leesanghun-droid/A-project/참고자료/6Layer_1.6T(50_90_100) 180306.pptx

A & P.Inc 제품설계팀

모델 :

업 체 : 그린전자
층 수 : 6 Layer
P C B 재 질 : FR-4
요 구 두 께 : 1.6 T
유 전 율 : 4.5(약)
작 성 일 : 2018,03,06
작 성 자 : 홍 성 준

TEST Layer
L2-L1, L2-L3,
L5-L4, L5-L6

Metrial Explain

P.S.R Coating
THIN CORE
PREPREG
COPPER
1080. → 0.06~0.07mm
1081. → 0.11~0.12mm
1082. → 0.17~0.18mm
7628HRC → 0.19~0.20mm
0.5 Oz는 약 0.018mm 1 Oz는 약 0.035mm

THIN CORE

TYPE Single Differential

Ohm 50 90 100

0.5 oz
1 oz
1 oz
1 oz
1 oz
0.5 oz

L1 COMP
1080
L2
L3
2116
L4
L5
1080
L6 SOLD

WIDTH WIDTH SPACE WIDTH SPACE

0.1 0.11 0.2 0.09 0.25
0.145 0.12 0.15 0.1 0.18
0.1 0.11 0.2 0.09 0.25

주의사항 : L3, L4 그라운드 동박 Fill 처리 必
ㄴ 2116 pp 사용에 따른 층간 Void 위험 有

0.5 T

0.5 T

Impedance Control : 50, 90, 100 (Ohm± 10%)
예 상 Thickness : 1.54 T

단위: mm
