leesanghun-droid/A-project/참고자료/FN210-RPI-W/FN210-RPI-W/FN210-RPI-W_부품배치도.pptx

주요내용

- 부품 변경 사항 – 스위치(SW1-4), EXT_MIC(4개)
  - 변경 부품
    - 전원스위치(SW1) / USER 스위치(SW2-4) – TOP에 배치 가능한 부품으로 변경하였습니다. – 회로도 수정 되었음.
(영성정공 ITS-1102T (https://www.devicemart.co.kr/goods/view?no=4305) + 스위치 노브(캡) NW3-A44 (https://www.devicemart.co.kr/goods/view?no=1322134))
    - EXT_MIC – Right Angle 제품으로 변경(Molex 5268-04 (http://www.icbanq.com/P000139721)) – PCB Footprint HDR4를 변경해주시면 될 것 같습니다.
(회로도에서 수정 없음)
- 마이크 간격 12cm로 유지 부탁드립니다.
- 지지대 홀 위치는 케이스에 따라 변경 가능합니다.
- 인터페이스(커넥터) 배치 주의사항.
  - 케이스 각 옆면 중앙에는 외부 마이크 배치될 수 있습니다.
  - 인터페이스 간 간격이 여유롭게 배치되었으면 합니다.
  - 케이스(Mic hole)와 PCB Top면의 간격에 따른 차이를 테스트할 예정입니다.

## Slide 2

케이스 배치 예상도

영역 외부 마이크를 위한 공간예정 - hole이 아님.

영역 PCB 보드 예상

마이크 hole – 보드 마이크와 밀착
스위치 4개 hole
(전원(SW1), USER 3개(SW2-4))
위치 미정
– 버튼 별 표시 중요

SW1

SW

SW

SW

Mic 간격
12cm

케이스 길이 180mm

U10
(Ethernet)

U7
(USB)

J8
(HDMI)

J1
(USB)

CON1
(SD)

J6 (AUDIO)

케이스 길이
155mm

TOP

BOTTOM

## Slide 3

TOP

SW1

SW2

MIC1

MIC2

MIC4

MIC3

Mic 간격
12cm

Mic 간격
12cm

LED1

LED2

SW3

W1
(WIFI)

LED3

LED4

SW4

- 지지대홀( ) 위치 미정
– 케이스에 맞추어 변경 가능
- LED/스위치 위치 미지정

## Slide 4

BOTTOM

J12 (SODIMM)

U10
(Ethernet)

U7
(USB)

J7

J11
(DEBUG)

J1
(USB)

EXT_MIC1

EXT_MIC2

EXT_MIC3

EXT_MIC4

CON1
(SD)

J6 (AUDIO)

J8
(HDMI)

- J7/J11 위치 미정
- EXT_MIC1-4 위치 미지정

J10 (CAM)

J9 (DISP)
