leesanghun-droid/A-project/참고자료/기본 4층 1.6T 50_90_100 (0.2PP_1.1T).pdf

4 Layer | 1.6 T
Target Zo | Ref.L | W | D | Target Zo | Ref.L | W | S | D | Target Zo | Ref.L | W | S | D
S/R | 0.012 | 3.50
1 | Top | 1/2oz+Plating | 0.040 | 2 | 0.355 | 2 | 0.170 | 0.100 | 2 | 0.150 | 0.120
Prepreg | 7628HRC | 0.200 | 4.18
2 | IN1 | 1oz | 0.032
Core | 1.1 | 1.040 | 4.30
3 | IN2 | 1oz | 0.032
Prepreg | 7628HRC | 0.200 | 4.18
4 | Bot | 1/2oz+Plating | 0.040 | 3 | 0.355 | 3 | 0.170 | 0.100 | 3 | 0.150 | 0.120
S/R | 0.012 | 3.50
| | | 1.608
DATE: | Impedance Controled
Stack_up | Singal Impedance | Differential Impedance
W: Line width | S: Line space | D: GND space | (unit: mm)

## Customer:

Layer: | Board Thickness:

90ohm (±10%)

Total Thickness

Layer | Type | Structure | Thickness | Er
50ohm (±10%) | 100ohm (±10%)
