leesanghun-droid/A-project/참고자료/FN210-RPI-W/FN210-RPI-W/FN210-RPI-W_차기버전_문의.pptx

케이스 관련 문의사항 – 차기 버전 확인 사항

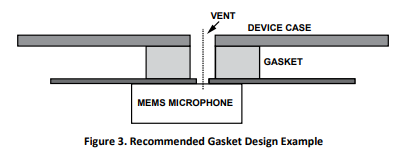
[picture p2: figure]

1. 마이크와 케이스를 밀착 시켜야 합니다. – 관련 문서 pdf 참조
또는, 옆의 그림 처럼 처리되어야 할 것 같습니다.
스위치 타공 부분을 살짝 크게 하여 최대한 밀착하였으면 합니다.
2. 케이스 가공 여부 확인 부탁 드립니다.
- 옆면 홈 부분 타공 가능한지 여부 – 실제 적용은 미정
- TOP면 6개 제거 가능 여부 – 보드 밀착 관련
- MIC 관련 – 케이스가 두꺼워 아래 빨간 박스부분에도 Gasket처리를 원합니다. - 이 경우 홀 최소 크기 문의

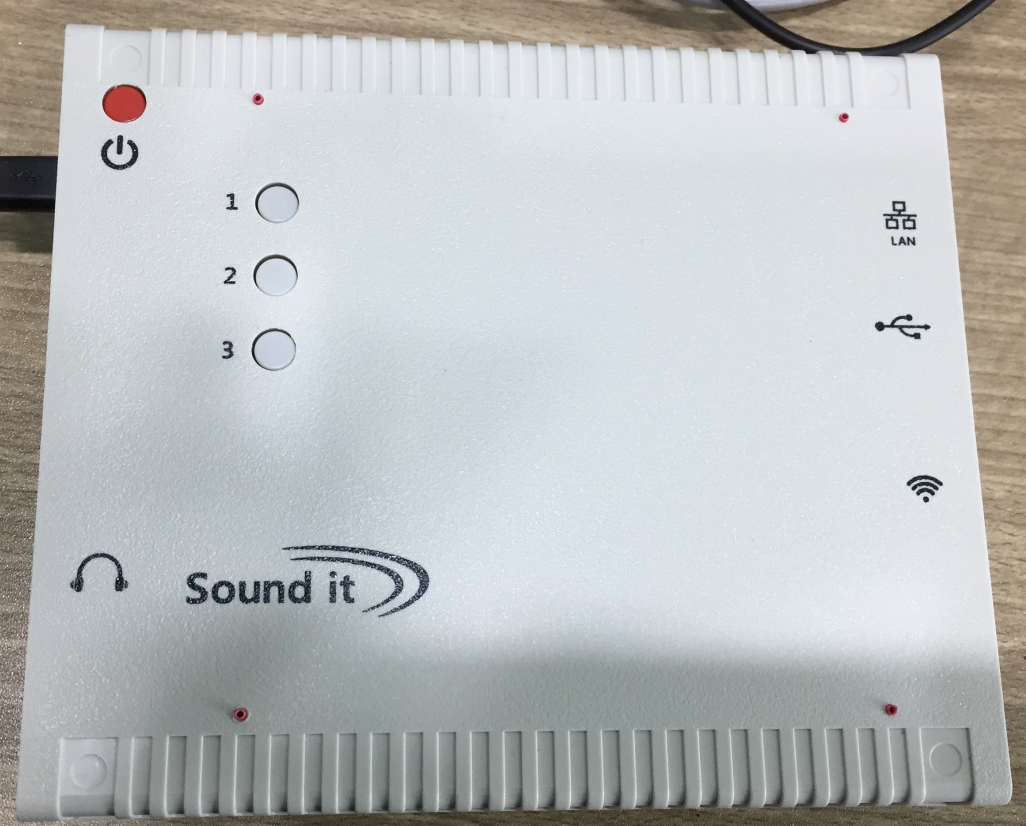
[picture p3: figure]
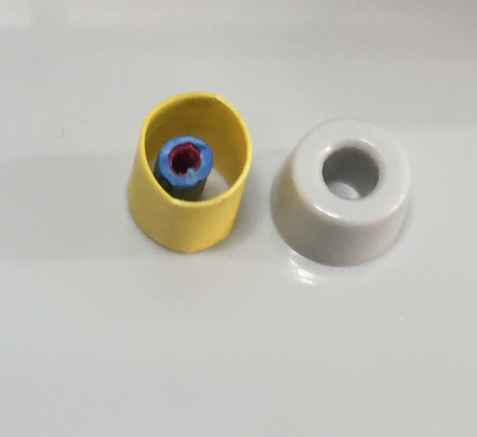
[picture p4: figure]

현재 Gasket 테스트

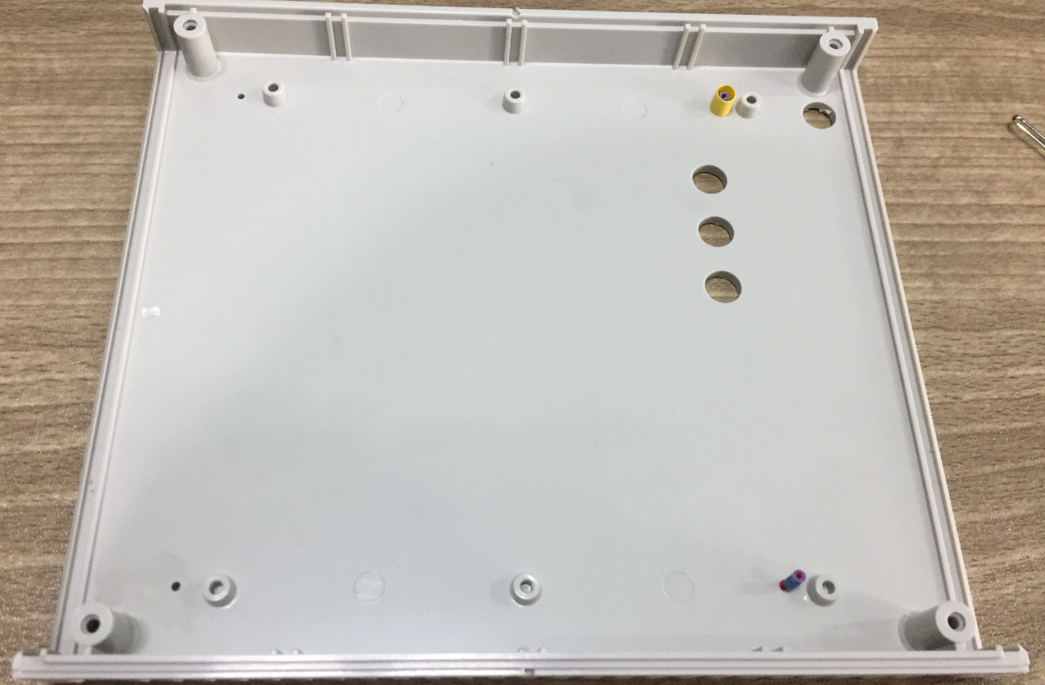
[picture p5: figure]
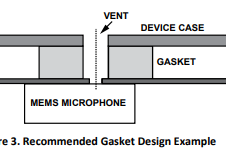
[picture p6: figure]

## Slide 2

차기 버전 변경 사항 - 예정

1. LED 순서 변경
2. J12(DDR2 SODIMM), W1(WiFi Module) Bottom면 배치
3. 외부 마이크 부분 변경 가능
4. 케이스 실크 변경
