leesanghun-droid/A-project/참고자료/FN210-RPI-W/FN210-RPI-W/배치 수정 부분.pptx

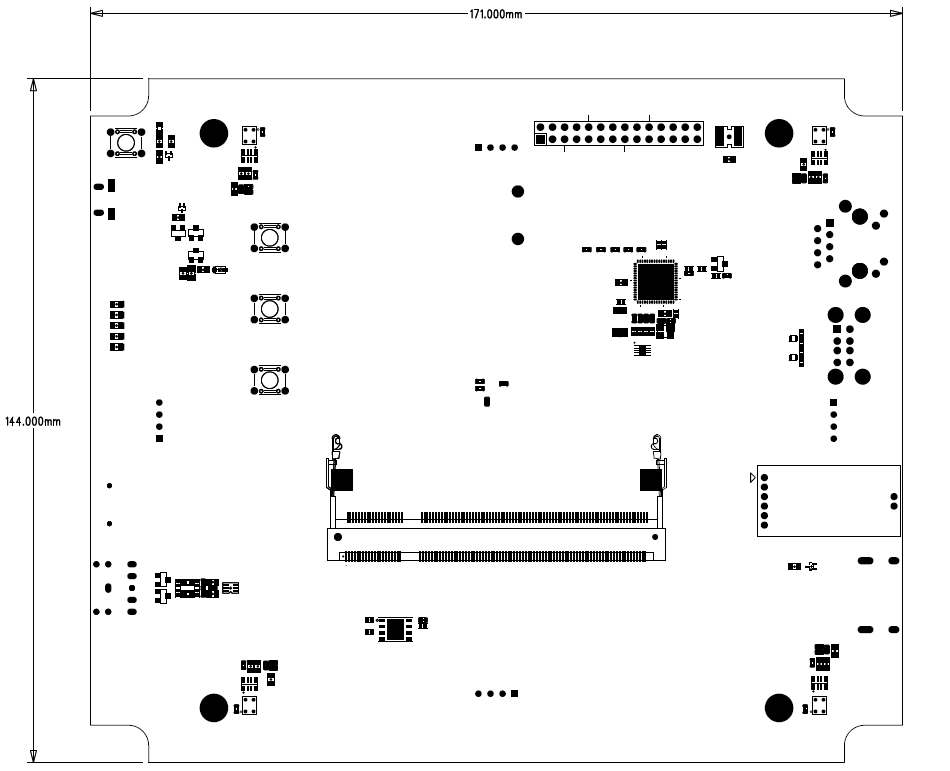
[picture p7: figure]

## Slide 2

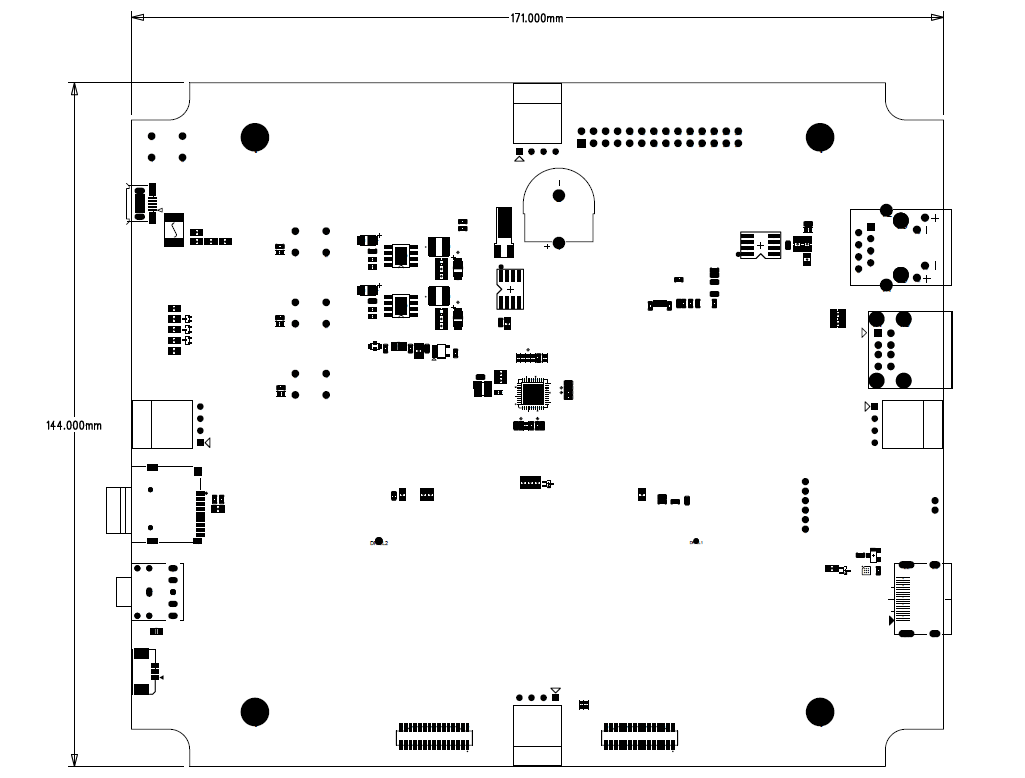
[picture p8: figure]
