leesanghun-droid/A-project/참고자료/FN210-RPI-W/FN210-RPI-W/pin_header_right_angle.pdf

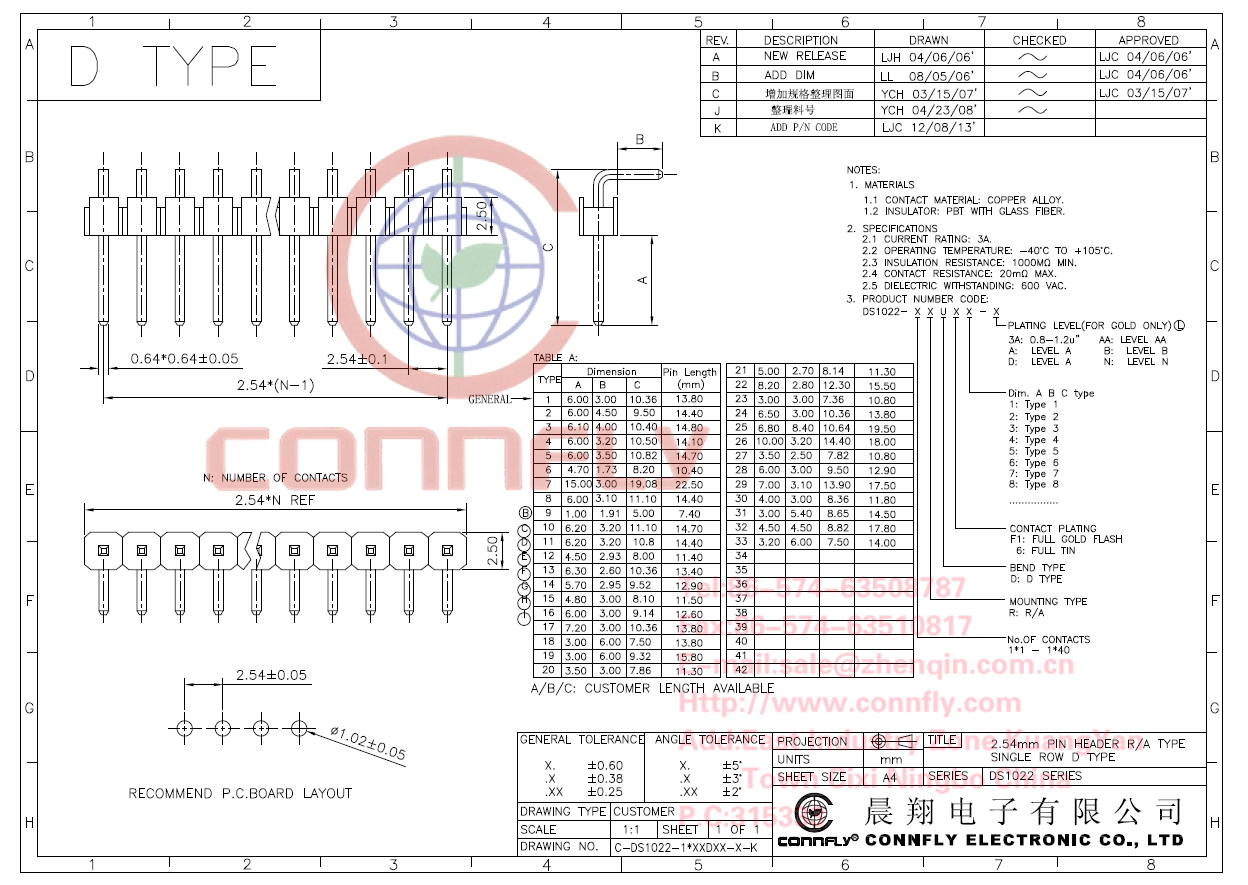
[picture p9: page 1]
