leesanghun-droid/A-project/참고자료/FN210-RPI-W/FN210-RPI-W/DataSheet/switch_Tact6_343.jpg

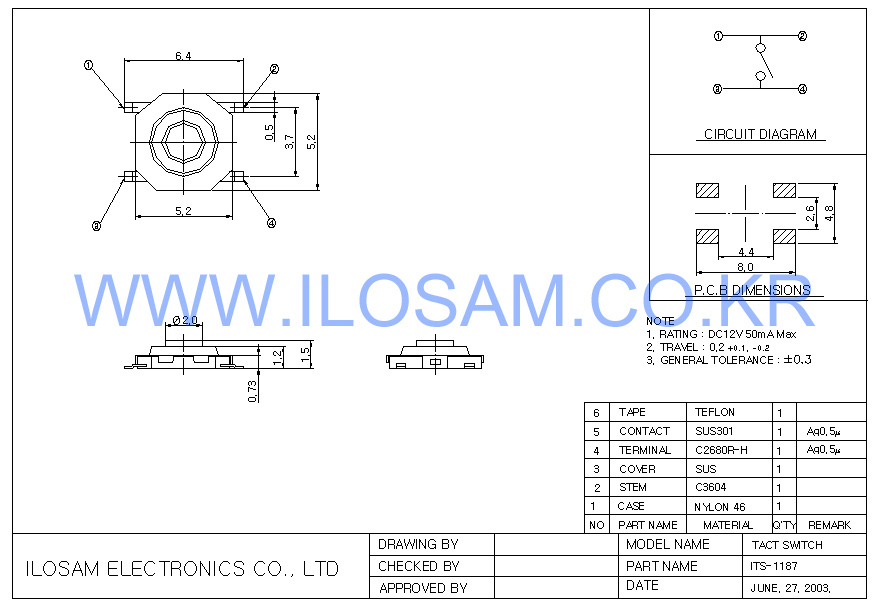
참고자료/FN210-RPI-W/FN210-RPI-W/DataSheet/switch_Tact6_343.jpg
