leesanghun-droid/A-project/참고자료/FN210-RPI-W/FN210-RPI-W/FN210-RPI-W_SOUNDIT_REV_A(190304)SCH-1AA.png

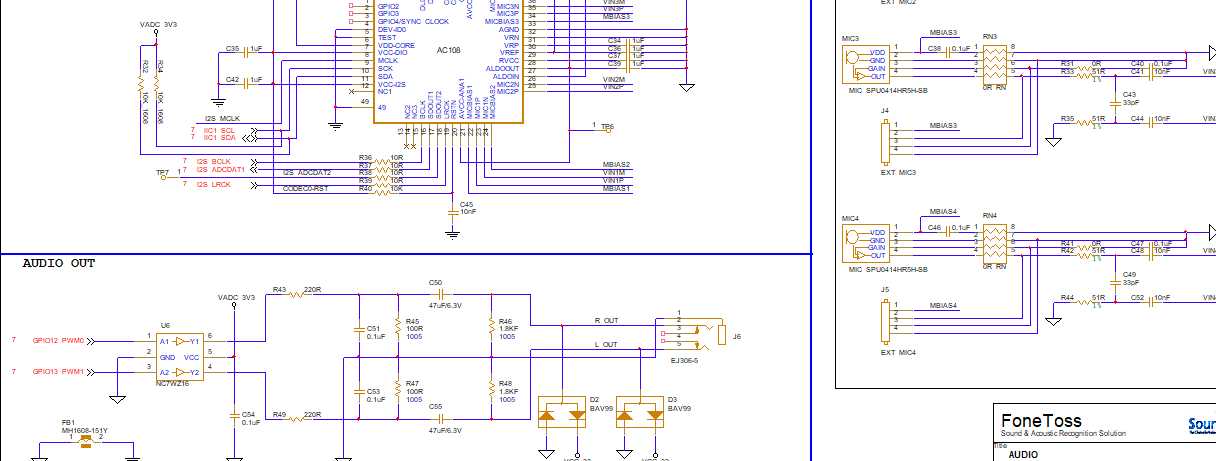
참고자료/FN210-RPI-W/FN210-RPI-W/FN210-RPI-W_SOUNDIT_REV_A(190304)SCH-1AA.png
