leesanghun-droid/A-project/참고자료/캡처1.PNG

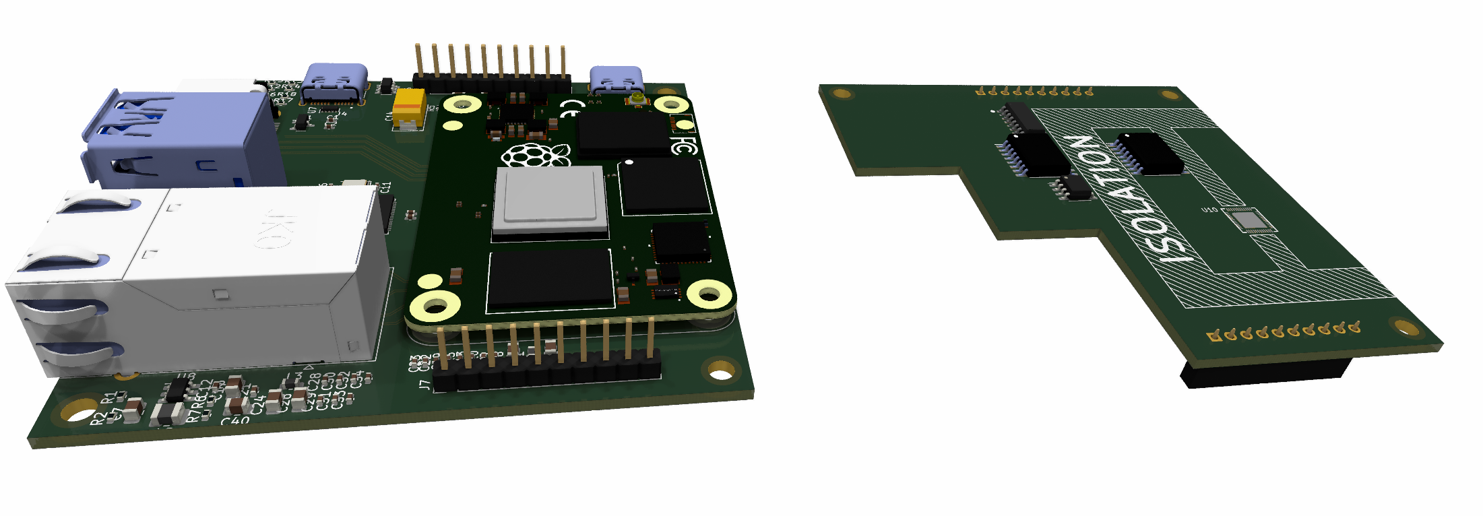
참고자료/캡처1.PNG
