leesanghun-droid/A-project/참고자료/AUDIO_BOM_2023.02.13.xlsx

[BOM] A 보드
Stock | Item | Quantity | Reference | Part | Descreption | 구매링크 | Package | PCB_Footprint | Vendor
 |  | 1 |  | AC108 | AUDIO CODEC | 알리바바
 |  | 1 |  | VL805 | USB 3.0 HUB | 알리익스프레스
 |  | 1 |  | DF40C-100DS-0.4V | CM4 CONNECTER | 알리익스프레스
 |  | 1 |  | RT9742SNGV | HDMI POWER SWITCH | 디바이스마트
 |  | 1 |  | DMG1012T | VL805 POWER MOSFET | 디바이스마트
 |  | 1 |  | AP22653W6 | CURRENT LIMIT SWITCH | 디바이스마트
 |  | 1 |  | X1G005961000212 | 25MHz ( VL805 ) | 디바이스마트 | 3225
 |  | 1 |  | SS-52000-003 | USB 3.0 STACKED | 디바이스마트 |  |  | Stewart Connector
 |  | 4 |  | TPD4EUSB30DQAR | USB 2.0 ESD | 디바이스마트 |  |  | TI
 |  | 2 |  | BLM18AG221SN1 | FERRITE BEAD 220 OHM | 디바이스마트 | 0603 |  | Murata Electronics
 |  | 35 |  | CL05B104JO5NNNC | 100nF | 디바이스마트 | C_0402_1005Metric |  | 삼성전기
 |  |  |  |  | 1uF |  | C_0402_1005Metric
 |  | 8 |  | CL21B106KOQNNNE | 10uF | 디바이스마트 |  |  | 삼성전기
 |  | 1 |  | JK0-0177NL | RJ45 / 1000Mbps | 알리익스프레스
 |  | 2 |  | 105450-0101 | USB C TYPE | 디바이스마트
 |  | 1 |  | AP3445LW6-7 | SWITCH REG | 디바이스마트
 |  | 1 |  | SI8663BB-B-IS1 | ISO INTERFACE IC | 디바이스마트
 |  | 2 |  | R05CTE05S-R | ISO POWER IC | 디바이스마트
 |  | 1 |  | ISO1540QDRQ1 | ISO I2C | 디바이스마트
 |  | 2 |  | TCR3RM33A,LF(SE | high precision LDO | 디바이스마트
 |  | 4 |  | Grove Female Header | Grove Female Header | 디바이스마트
 |  | 1 |  | ASEMB-24.000MHZ-LC-T | AC108 CLOCK | 디바이스마트
 |  | 1 |  | 685119134923 ( HDMI ) | HDMI CONNECTER | 디바이스마트
 |  | 2 |  | T495B107M010ATE500 | CAP TANT 100UF 10V 20% 2528 | 디바이스마트
260 |  |  |  | 0.1uF 16V 0402 |  |  | C_0402_1005Metric
 |  | ~~1~~ | ~~J6~~ | ~~MOLEX_503398-1892~~ | ~~SD-CARD~~ | ~~디바이스마트~~
 |  | ~~1~~ | ~~J2~~ | ~~HD02-19-M-MSMT-TR~~ | ~~HDMI CONNECTER~~ | ~~디바이스마트~~
 |  | ~~1~~ | ~~U6~~ | ~~AP3428KTTR-G1~~ | ~~3.3V to 1.05V~~ | ~~마우저~~
 |  | ~~1~~ | ~~U7~~ | ~~AP2127K-ADJTRG1~~ | ~~3.3V to 1.05V~~ | ~~디바이스마트~~
 |  | ~~1~~ | ~~J4~~ | ~~SS-52100-003~~ | ~~USB 2.0 STACKED~~ | ~~디바이스마트~~ |  |  | Stewart Connector
 |  | ~~2~~ | ~~U9~~ | ~~74LVC1G07GW,125~~ | ~~BUF NON-INVERT 5.5V~~ | ~~디바이스마트~~ | 5TSSOP |  | Nexperia USA Inc.
