leesanghun-droid/A-project/참고자료/FN210-RPI-W/FN210-RPI-W/FN210-RPI-W_SOUNDIT_REV_A_BOM_20190304.xlsx

[BOM] FN210-RPI-W Rev.A
Item | Quantity | Reference | Part | Package | PCB_Footprint | Vendor | Descreption
1 | 1 | BT1 | CR1220 | CR1220 | BATTERY(HOLDER_CR1220)DIP | Keystone Electronics | Coin Cell Battery Holders
2 | 1 | CON1 | SCHA1B0100 | SCHA1B0100 (http://www.icbanq.com/P004961798) | CARD-ATOM | Chipsen | Micro SD Socket
3 | 4 | CT1,CT2,CT3,CT4 | 10uF_TANA | TAN_A | TAN_A | AVX | 10V/3216/20%
4 | 3 | C1,C4,C6 | 0.1uF_1608 | C1608 | C1608
5 | 1 | C2 | 22uF | c2012 | C2012
6 | 16 | C3,C5,C15,C16,C22,C23,C25,C29,C30,C33,C34,C35,C36,C37,C39,C42 | 1uF | C1005 | C1005
7 | 1 | C7 | 1nF | C4532 | C4532
8 | 4 | C8,C9,C56,C57 | 47uF | c2012 | C2012
9 | 40 | C10,C11,C12,C13,C17,C18,C24,C26,C38,C40,C46,C47,C51,C53,C54,C60,C61,C62,C63,C65,C66,C67,C68,C69,C70,C71,C72,C73,C74,C75,C76,C78,C79,C84,C87,C88,C89,C90,C94,C95 | 0.1uF | C1005 | C1005
10 | 1 | C14 | 10uF_2012 | c2012 | C2012
11 | 10 | C19,C21,C28,C32,C41,C44,C45,C48,C52,C98 | 10nF | C1005 | C1005
12 | 6 | C20,C31,C43,C49,C85,C86 | 33pF | C1005 | C1005
13 | 2 | C27,C97 | 10uF | C1005 | C1005
14 | 2 | C50,C55 | 47uF/6.3V | C1608 | C1608
15 | 1 | C58 | 1uF/6.3V | C1005 | C1005
16 | 5 | C59,C64,C77,C96,C99 | 4.7uF | C1005 | C1005
17 | 4 | C80,C81,C82,C83 | 100pF | C1005 | C1005
18 | 3 | C91,C92,C93 | 0.22uF | C1005 | C1005
19 | 1 | DN1 | ESD1014MUTAG | UDFN-10 | UDFN10 | ON Semiconductor | TVS Diodes - Transient Voltage Suppressors LOW CAP TVS ARRAY
20 | 1 | D1 | 1SS315TPH3F | USC-2 | DIODE_USC | TOSHIBA | Schottky Diodes & Rectifiers PIN DIODE
21 | 2 | D2,D3 | BAV99 | SOT-23-3 | SOT23 | ON Semiconductor | Diodes - General Purpose, Power, Switching 70V 215mA Dual
22 | 4 | D4,D5,D6,D7 | LXES15AAA1-133 | ESD1005 | ESD_1005 | Murata Electronics | ESD Suppressors
23 | 1 | FB1 | MH1608-151Y | L1608 | L1608 | Bourns | Ferrite Beads
24 | 2 | FB2,FB3 | LC 90 150mA 0504 | MCF12102H900 | MCF12102H900 | Taiyo Yuden | Common Mode Chokes / Filters 1210 0.15A 90ohms Com Mode Choke Coil
25 | 2 | FB4,FB5 | BLM18PG121 | L1608 | L1608 | Murata | Ferrite Beads 0603
26 | 1 | F1 | MF-MSMF200 | 1812(4532 metric) | FUSE_4532 | Bourns | Resettable Fuses - PPTC
27 | 1 | J1 | USB5F | HI05-AG0272 | USB-MICRO_HI05-AG0272 | 협진 | MICRO USB B
28 | 1 | J2 | EXT_MIC1 | 5268-04 | HDR4 | Molex
29 | 1 | J3 | EXT_MIC2 | 5268-04 | HDR4 | Molex
30 | 1 | J4 | EXT_MIC3 | 5268-04 | HDR4 | Molex
31 | 1 | J5 | EXT_MIC4 | 5268-04 | HDR4 | Molex
32 | 1 | J6 | EJ306-5 | PJ-307 (http://www.icbanq.com/P005658810) | PHONEJACK-EJ306-5 | GEC | 3.5Pie Phone Jack
33 | 1 | J7 | GPIO |  | HDR14X2
34 | 1 | J8 | 47151-1051 | 47151-1051 | HDMI_47151-001 | Molex | HDMI, Displayport & DVI Connectors
35 | 2 | J9,J10 | 1-1734248-5 | 1-1734248-5 | 117342485 | TE Connectivity AMP Connectors] | CONN FPC VERT 15POS 1.00MM SM
36 | 1 | J11 | DEBUG | 53398-0371 | MOLEX53398-03 | Molex | Headers VERTICAL HDR SMT 3P
37 | 1 | J12 | DDR2 SODIMM | 1473149-4 | TE_14731494 | TE Connectivity AMP Connectors | DIMM Connectors .6MM 200D R/SM 1.8V DIMMSO DDR
38 | 1 | LED1 | WHITE | D1608 | LED1608
39 | 1 | LED2 | RED | D1608 | LED1608
40 | 1 | LED3 | GREEN | D1608 | LED1608
41 | 1 | LED4 | BLUE | D1608 | LED1608
42 | 1 | LED5 | YELLOW | D1608 | LED1608
43 | 2 | L1,L2 | 4.7u | SRN4018-4R7M | SRN4018 | Bourns | Fixed Inductors
44 | 1 | L3 | FLT_HIFREQ_.47UF | YFF21PC | YFF21PC | TDK | Feed Through Capacitors
45 | 2 | L4,L5 | BLM21PG221SN1D | L2012 | L2012 | Murata | Ferrite Beads 0805
46 | 4 | MH1,MH2,MH3,MH4 | MHOLE |  | HOLE3.5-NTH
47 | 4 | MIC1,MIC2,MIC3,MIC4 | MIC_SPU0414HR5H-SB | SPU0414HR5H-SB | MIC-SPU0414HR5H-SB | Knowles | MEMS Microphones
48 | 1 | Q1 | IRLML6401 | SOT-23-3 | SOT23 | Infineon Technologies | MOSFET MOSFT P-Ch -4.3A 50mOhm 10nC Log Lvl
49 | 5 | Q2,Q5,Q8,Q9,Q10 | DTC124EE | SOT-416-3 | SOT-416 | ROHM Semiconductor | Digital Transistors DIGITAL NPN 50V 100MA EMD3
50 | 2 | Q3,Q4 | DMG3420U-7 | SOT-23-3 | SOT-23-3 | Diodes Incorporated | MOSFET Small Signal MOSFET,N-CHANNEL
51 | 3 | Q6,Q7,Q11 | DMG1012T | SOT-523-3 | SOT523 | Diodes Incorporated | MOSFET BVDSS
52 | 4 | RN1,RN2,RN3,RN4 | 0R_RN | RN3216 | RNET3216 | Bourns | Resistor Networks & Arrays 000ohm 5% Concave 4resistors
53 | 10 | R2,R3,R20,R24,R27,R31,R41,R77 | 0R | R1608 | R1608
54 | 3 | R4,R5,R6 | 10KJ | R1608 | R1608
55 | 3 | R7,R8,R72,R73,R80 | 1KJ | R1608 | R1608
56 | 1 | R9 | 10R_1608 | R1608 | R1608
57 | 2 | R10,R85 | 100KJ_1608 | R1608 | R1608
58 | 4 | R11,R12,R15,R16 | 100KJ | R1005 | R1005
59 | 1 | R13 | 47KF | R1608 | R1608
60 | 2 | R14,R17 | 15KF | R1608 | R1608
61 | 1 | R18 | 12KF | R1608 | R1608
62 | 1 | R19 | 1M1 | R1608 | R1608
63 | 1 | R21 | 47K | R1005 | R1005
64 | 1 | R22 | 2.2K | R1005 | R1005
65 | 6 | R23,R36,R37,R38,R39,R62 | 10R | R1005 | R1005
66 | 8 | R25,R26,R28,R30,R33,R35,R42,R44 | 51R | R1608 | R1608
67 | 9 | R29,R40,R52,R63,R64,R65,R67,R68,R69 | 10K | R1005 | R1005
68 | 2 | R32,R34 | 10K_1608 | R1608 | R1608
69 | 6 | R43,R49,R50,R74 | 220R | R1608 | R1608
70 | 2 | R45,R47 | 100R | R1005 | R1005
71 | 4 | R46,R48,R75,R76 | 1.8KF | R1005 | R1005
72 | 1 | R51 | 12KJ | R1005 | R1005
73 | 4 | R53,R54,R55,R56 | 49.9RJ | R1005 | R1005
74 | 1 | R57 | 10KF | R1608 | R1608
75 | 1 | R58 | 12.4KJ | R1005 | R1005
76 | 2 | R59,R60 | 330R | R1005 | R1005
77 | 1 | R61 | 1M | R1608 | R1608
78 | 7 | R70,R78,R79,R81,R82,R83,R84 | 100KF | R1608 | R1608
79 | 4 | SW1,SW2,SW3,SW4 | ITS-1102T | SW4P_1102_DIP (https://www.devicemart.co.kr/goods/view?no=4305) | SW4P_1102_DIP |  | 스위치 노브(캡) 링크: NW3-A44 (https://www.devicemart.co.kr/goods/view?no=1322134)
80 | 7 | TP1,TP2,TP3,TP4,TP5,TP6,TP7 | TP1.5 |  | TP
81 | 2 | U1,U2 | RT9018A-18GSP | SOP-8 | SOP8-G-1_27-5_0X6_2 | RT9018A-18GSP | IC REG LDO 1.8V/ADJ 3A 8SOP
82 | 1 | U3 | APX803-29 | SOT-23-3 | SOT23 | Diodes Incorporated | Supervisory Circuits 3-Pin MPU Reset 30uA 2.5V, 3V, 3.3V, 5V
83 | 1 | U4 | LDK320AM33R | SOT-23-5 | SOT23-5P | STMicroelectronics | LDO Voltage Regulators 200 mA low quiescent current and high PSRR voltage regulator
84 | 1 | U5 | AC108 | AC108 | QFN48_4_6X6
85 | 1 | U6 | NC7WZ16 | SC-70-6 | SC70-6 | ON Semiconductor | Buffers & Line Drivers
86 | 1 | U7 | DUAL_USB_A | DUAL_USB_A | DUAL_USB_A | Connfly
87 | 1 | U8 | MIC2026-1YM | SOIC-8 | SOIC8 | Microchip Technology | Power Switch ICs
88 | 1 | U9 | LAN9514 | QFN-64 | IC_QFN64_0.5P_9X9_LAN9514 | Microchip Technology | USB Interface IC
89 | 1 | U10 | LU1T041X-43LF | RJ-45 | RJ45_LU1T041X-43LF | Bothhand Enterprise Inc.
90 | 1 | U11 | AP2331W | SC59-3 | SC59 | Diodes Incorporated | Power Switch ICs
91 | 1 | U12 | ESD5384 | WLCSP-9 | WLCSP9_1.14X1.14 | ON Semiconductor | TVS Diodes 4 CHAN
92 | 1 | U13 | IS25LP128-JKLE | WSON8_127_6X5 | WSON8_127_6X5 | ISSI | NOR Flash 128Mb QPI/QSPI, WSON, RoHS
93 | 1 | U14 | DS1307Z | SOIC-8 | SOIC8 | Maxim Integrated | Real Time Clock
94 | 1 | W1 | WG209 | WG209 | WIFI-MODULE-WG209 | SKYLAB | USB WiFi Module
95 | 1 | X1 | 24MHz | OSC3225 | OSC3225 | Abracon LLC | OSCILLATOR 24.000 MHZ 3.3V SMD
96 | 1 | X2 | 25.000MHz | OSC3225 | OSC3225 | Diodes Incorporated | CRYSTAL 25MHZ 20PF SMD
97 | 1 | X3 | 32.768KHz | CRYSTAL_6020 | CRYSTAL_6020 | CTS Electronic Components | Crystals 32.768kHz 12.5pF 20ppm -10C +60C
