leesanghun-droid/A-project/참고자료/FN200-RPI-CM_REV_A(180608)CNT-1A.xlsx

PartType | RefDes | PartDecal | Pins | Layer | Orient. | X | Y | SMD | Glued
BATTERY(HOLDER_CR1220)DIP | BT1 | BATTERY(HOLDER_CR1220)DIP | 2 | Bottom | 180 | 45 | 20 | No | No
C1005 | C1 | C1005 | 2 | Top | 0 | 23.05 | 104.55 | Yes | No
C2012 | C2 | C2012 | 2 | Top | 90 | 21.75 | 94 | Yes | No
C1005 | C3 | C1005 | 2 | Bottom | 0 | 11.85 | 81.75 | Yes | No
C1005 | C4 | C1005 | 2 | Top | 90 | 39 | 95.8 | Yes | No
C2012 | C5 | C2012 | 2 | Top | 180 | 32 | 97.4 | Yes | No
C1005 | C6 | C1005 | 2 | Top | 0 | 38 | 93.4 | Yes | No
C1005 | C7 | C1005 | 2 | Top | 180 | 34.75 | 99.9 | Yes | No
C2012 | C8 | C2012 | 2 | Top | 180 | 32 | 95.4 | Yes | No
C1005 | C9 | C1005 | 2 | Top | 90 | 59.35 | 13.15 | Yes | No
C1005 | C10 | C1005 | 2 | Top | 270 | 64.55 | 12.15 | Yes | No
C1005 | C11 | C1005 | 2 | Bottom | 180 | 90.15 | 77.7 | Yes | No
C1005 | C12 | C1005 | 2 | Top | 270 | 96.9 | 69.1 | Yes | No
C1005 | C13 | C1005 | 2 | Top | 270 | 95.85 | 69.1 | Yes | No
C1005 | C14 | C1005 | 2 | Top | 270 | 43 | 80.75 | Yes | No
C1005 | C15 | C1005 | 2 | Top | 0 | 36 | 80.1 | Yes | No
C1005 | C16 | C1005 | 2 | Top | 0 | 44 | 83.5 | Yes | No
C1005 | C17 | C1005 | 2 | Top | 270 | 42 | 84 | Yes | No
C1005 | C18 | C1005 | 2 | Top | 0 | 44 | 84.5 | Yes | No
C1005 | C19 | C1005 | 2 | Top | 270 | 83 | 80.75 | Yes | No
C1005 | C20 | C1005 | 2 | Top | 180 | 73.5 | 78.75 | Yes | No
C1005 | C21 | C1005 | 2 | Top | 180 | 72.25 | 81.25 | Yes | No
C1005 | C22 | C1005 | 2 | Top | 270 | 74 | 81.75 | Yes | No
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
C1005 | C138 | C1005 | 2 | Top | 270 | 52.9 | 13.95 | Yes | No
C1005 | C139 | C1005 | 2 | Top | 180 | 29.25 | 110.65 | Yes | No
C1005 | C140 | C1005 | 2 | Top | 270 | 56.15 | 47.1 | Yes | No
C1005 | C141 | C1005 | 2 | Top | 0 | 28.5 | 64.35 | Yes | No
C1005 | C142 | C1005 | 2 | Top | 180 | 14.6 | 39.85 | Yes | No
C1005 | C143 | C1005 | 2 | Bottom | 270 | 18.1 | 34.95 | Yes | No
C1005 | C144 | C1005 | 2 | Top | 180 | 14.6 | 40.95 | Yes | No
12505WR_2 | CON1 | 12505WR_2 | 4 | Top | 90 | 117 | 47 | Yes | No
12505WR_2 | CON2 | 12505WR_2 | 4 | Top | 90 | 117 | 28 | Yes | No
12505WR_2 | CON3 | 12505WR_2 | 4 | Top | 90 | 117 | 37.5 | Yes | No
12505WR_2 | CON4 | 12505WR_2 | 4 | Top | 90 | 117 | 18.5 | Yes | No
CARD-ATOM | CON5 | CARD-ATOM | 15 | Bottom | 90 | 14.5 | 42 | No | No
TAN_B | CT1 | TAN_B | 2 | Top | 270 | 13 | 104.5 | Yes | No
TAN_B | CT2 | TAN_B | 2 | Top | 270 | 16.5 | 104.5 | Yes | No
TAN_B | CT3 | TAN_B | 2 | Bottom | 180 | 23 | 95.75 | Yes | No
TAN_P | CT4 | TAN_P | 2 | Top | 90 | 98.7 | 49.65 | Yes | No
TAN_P | CT5 | TAN_P | 2 | Top | 90 | 98.7 | 30.65 | Yes | No
TAN_P | CT6 | TAN_P | 2 | Top | 270 | 93.7 | 44.3 | Yes | No
TAN_P | CT7 | TAN_P | 2 | Top | 270 | 93.7 | 25.3 | Yes | No
TAN_P | CT8 | TAN_P | 2 | Top | 90 | 102.95 | 48.6 | Yes | No
TAN_P | CT9 | TAN_P | 2 | Top | 90 | 102.95 | 29.6 | Yes | No
TAN_P | CT10 | TAN_P | 2 | Top | 90 | 98.7 | 21.15 | Yes | No
TAN_P | CT11 | TAN_P | 2 | Top | 90 | 98.7 | 40.15 | Yes | No
TAN_P | CT12 | TAN_P | 2 | Top | 270 | 93.7 | 15.8 | Yes | No
TAN_P | CT13 | TAN_P | 2 | Top | 270 | 93.7 | 34.8 | Yes | No
TAN_P | CT14 | TAN_P | 2 | Top | 90 | 102.95 | 20.1 | Yes | No
TAN_P | CT15 | TAN_P | 2 | Top | 90 | 102.95 | 39.1 | Yes | No
DIODE_USC | D1 | DIODE_USC | 2 | Bottom | 180 | 14 | 96.75 | Yes | No
SOT23 | D3 | SOT23 | 3 | Top | 180 | 14 | 18.2 | Yes | No
SOT23 | D4 | SOT23 | 3 | Top | 0 | 13.95 | 25.85 | Yes | No
SOT23 | D5 | SOT23 | 3 | Bottom | 270 | 3.85 | 63.35 | Yes | No
FUSE_4532 | F1 | FUSE_4532 | 2 | Bottom | 270 | 9.5 | 94.25 | Yes | No
L1608 | FB1 | L1608 | 2 | Top | 0 | 9.5 | 106.25 | Yes | No
L1608 | FB2 | L1608 | 2 | Top | 0 | 9.5 | 102.75 | Yes | No
L1608 | FB3 | L1608 | 2 | Top | 270 | 96.9 | 49.4 | Yes | No
L1608 | FB4 | L1608 | 2 | Top | 270 | 96.9 | 30.4 | Yes | No
L1608 | FB5 | L1608 | 2 | Top | 270 | 96.9 | 20.9 | Yes | No
L1608 | FB6 | L1608 | 2 | Top | 270 | 96.9 | 39.9 | Yes | No
L1608 | FB7 | L1608 | 2 | Top | 270 | 22 | 37 | Yes | No
C1005 | FB8 | C1005 | 2 | Bottom | 90 | 100.2 | 88.85 | Yes | No
C1005 | FB9 | C1005 | 2 | Bottom | 0 | 100.6 | 55.05 | Yes | No
HOLE3.5/NTH_VISION | HH1 | HOLE3.5/NTH_VISION | 3 | Top | 270 | 5 | -5 | No | Yes
HOLE3.5/NTH_VISION | HH2 | HOLE3.5/NTH_VISION | 3 | Top | 90 | 115 | -5 | No | Yes
HOLE3.5/NTH_VISION | HH3 | HOLE3.5/NTH_VISION | 3 | Top | 270 | 5 | 125 | No | No
HOLE3.5/NTH_VISION | HH4 | HOLE3.5/NTH_VISION | 3 | Top | 90 | 115 | 125 | No | Yes
MICRO_USB_5P | J1 | MICRO_USB_5P | 11 | Bottom | 180 | 5.5 | 93.5 | No | No
MICRO_USB_5P | J2 | MICRO_USB_5P | 11 | Bottom | 180 | 5.5 | 82 | No | No
HDR3 | J3 | HDR3 | 3 | Top | 180 | 60.75 | 87.45 | No | No
HDR8X2 | J4 | HDR8X2 | 16 | Top | 0 | 89.9 | 7 | No | No
HDR6 | J5 | HDR6 | 6 | Top | 270 | 59 | 33 | No | No
HDR8X2 | J6 | HDR8X2 | 16 | Top | 0 | 67.55 | 7 | No | No
PHONEJACK-EJ306-5 | J7 | PHONEJACK-EJ306-5 | 10 | Bottom | 180 | 3.7 | 22 | No | No
SFW15R2STE1LF | J8 | SFW15R2STE1LF | 17 | Bottom | 180 | 68.5 | 114 | Yes | No
SFW15R2STE1LF | J9 | SFW15R2STE1LF | 17 | Bottom | 180 | 47.5 | 114 | Yes | No
HDMI_47151-001 | J10 | HDMI_47151-001 | 23 | Bottom | 180 | 88 | 119 | No | No
HDR14X2 | J11 | HDR14X2 | 28 | Top | 180 | 46.25 | 9.5 | No | No
TE_14731494 | J12 | TE_14731494 | 204 | Bottom | 0 | 57.75 | 70 | No | No
LPF6028 | L1 | LPF6028 | 2 | Top | 270 | 21.75 | 100 | Yes | No
IND_SRN4018 | L2 | IND_SRN4018 | 2 | Top | 180 | 34.05 | 91.05 | Yes | No
IND_SRN4018 | L3 | IND_SRN4018 | 2 | Top | 0 | 38.85 | 102.1 | Yes | No
L2012 | L4 | L2012 | 2 | Top | 0 | 57.05 | 12 | Yes | No
L1005(0402) | L5 | L1005(0402) | 2 | Top | 270 | 110.6 | 45.9 | Yes | No
L1005(0402) | L6 | L1005(0402) | 2 | Top | 270 | 110.6 | 26.9 | Yes | No
L1005(0402) | L7 | L1005(0402) | 2 | Top | 90 | 111.8 | 48.15 | Yes | No
L1005(0402) | L8 | L1005(0402) | 2 | Top | 90 | 111.8 | 29.15 | Yes | No
L1005(0402) | L9 | L1005(0402) | 2 | Top | 270 | 110.6 | 36.4 | Yes | No
L1005(0402) | L10 | L1005(0402) | 2 | Top | 90 | 111.8 | 19.65 | Yes | No
L1005(0402) | L11 | L1005(0402) | 2 | Top | 90 | 111.8 | 38.65 | Yes | No
L1005(0402) | L12 | L1005(0402) | 2 | Top | 270 | 110.6 | 17.4 | Yes | No
YFF21PC | L13 | YFF21PC | 4 | Top | 0 | 52.5 | 9 | Yes | No
L2012 | L14 | L2012 | 2 | Top | 0 | 57.05 | 8.7 | Yes | No
L1608 | L17 | L1608 | 2 | Bottom | 180 | 93 | 99.7 | Yes | No
L1608 | L18 | L1608 | 2 | Bottom | 90 | 90.75 | 97.45 | Yes | No
LED1608 | LED1 | LED1608 | 2 | Top | 0 | 6.3 | 89.25 | Yes | No
LED1608 | LED2 | LED1608 | 2 | Top | 0 | 6.3 | 87.5 | Yes | No
LED1608 | LED3 | LED1608 | 2 | Top | 0 | 6.3 | 85.75 | Yes | No
MIC-SPU0414HR5H-SB | MIC1 | MIC-SPU0414HR5H-SB | 4 | Top | 0 | 40 | 80 | Yes | Yes
MIC-SPU0414HR5H-SB | MIC2 | MIC-SPU0414HR5H-SB | 4 | Top | 0 | 80 | 80 | Yes | Yes
MIC-SPU0414HR5H-SB | MIC3 | MIC-SPU0414HR5H-SB | 4 | Top | 0 | 80 | 40 | Yes | Yes
MIC-SPU0414HR5H-SB | MIC4 | MIC-SPU0414HR5H-SB | 4 | Top | 0 | 40 | 40 | Yes | Yes
DG350-2P | P1 | DG350-2P | 2 | Bottom | 270 | 4 | 104.5 | No | No
DG350-2P | P2 | DG350-2P | 2 | Bottom | 270 | 5 | 71.25 | No | No
DG350-2P | P3 | DG350-2P | 2 | Bottom | 270 | 5 | 57.3 | No | No
SOT23 | Q1 | SOT23 | 3 | Bottom | 90 | 18 | 95.75 | Yes | No
SOT523 | Q2 | SOT523 | 3 | Top | 270 | 8.7 | 78.75 | Yes | No
SOT523 | Q3 | SOT523 | 3 | Top | 180 | 17 | 72.35 | Yes | No
SOT523 | Q4 | SOT523 | 3 | Top | 0 | 14.8 | 71.25 | Yes | No
SOT523 | Q5 | SOT523 | 3 | Top | 180 | 75.65 | 107.45 | Yes | No
SOT523 | Q6 | SOT523 | 3 | Top | 270 | 78.5 | 103.3 | Yes | No
SOT-416 | Q7 | SOT-416 | 3 | Top | 270 | 18.85 | 12.9 | Yes | No
SOT-416 | Q8 | SOT-416 | 3 | Bottom | 0 | 31.6 | 77.4 | Yes | No
R1005 | R1 | R1005 | 2 | Top | 270 | 19.2 | 107.95 | Yes | No
R1005 | R2 | R1005 | 2 | Top | 270 | 26.55 | 107.95 | Yes | No
R1005 | R3 | R1005 | 2 | Top | 270 | 25.3 | 107.95 | Yes | No
R1608 | R4 | R1608 | 2 | Bottom | 0 | 12.2 | 80.45 | Yes | No
R1005 | R5 | R1005 | 2 | Bottom | 0 | 14 | 94.8 | Yes | No
R1608 | R6 | R1608 | 2 | Bottom | 270 | 16.85 | 92.55 | Yes | No
R1608 | R7 | R1608 | 2 | Top | 270 | 6.6 | 78.5 | Yes | No
R1005 | R8 | R1005 | 2 | Top | 0 | 3.65 | 87.5 | Yes | No
R1608 | R9 | R1608 | 2 | Top | 270 | 40.25 | 95.9 | Yes | No
R1005 | R10 | R1005 | 2 | Top | 0 | 9.15 | 89.25 | Yes | No
R1608 | R11 | R1608 | 2 | Top | 180 | 16.75 | 75 | Yes | No
R1608 | R12 | R1608 | 2 | Top | 180 | 15.05 | 69.25 | Yes | No
R1005 | R13 | R1005 | 2 | Bottom | 0 | 87.75 | 79.95 | Yes | No
R1608 | R14 | R1608 | 2 | Top | 270 | 96.25 | 72.5 | Yes | No
R1005 | R15 | R1005 | 2 | Bottom | 0 | 85.75 | 79.95 | Yes | No
R1608 | R16 | R1608 | 2 | Top | 180 | 36.25 | 78.75 | Yes | No
R1608 | R17 | R1608 | 2 | Top | 0 | 39.75 | 83.5 | Yes | No
R1608 | R18 | R1608 | 2 | Top | 180 | 44.25 | 86 | Yes | No
R1608 | R19 | R1608 | 2 | Top | 180 | 76 | 78.75 | Yes | No
R1608 | R20 | R1608 | 2 | Top | 180 | 76 | 81.25 | Yes | No
R1608 | R21 | R1608 | 2 | Top | 180 | 74.75 | 83.75 | Yes | No
R1608 | R22 | R1608 | 2 | Top | 180 | 75.75 | 38.75 | Yes | No
R1608 | R23 | R1608 | 2 | Top | 180 | 75.75 | 41.25 | Yes | No
R1608 | R24 | R1608 | 2 | Top | 180 | 74.25 | 43.75 | Yes | No
R1608 | R25 | R1608 | 2 | Top | 180 | 36.5 | 38.75 | Yes | No
R1608 | R26 | R1608 | 2 | Top | 0 | 39.75 | 43.75 | Yes | No
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
R1005 | R95 | R1005 | 2 | Bottom | 270 | 6.6 | 63.85 | Yes | No
R1005 | R96 | R1005 | 2 | Bottom | 270 | 9.1 | 63.85 | Yes | No
R1608 | R97 | R1608 | 2 | Top | 90 | 14.25 | 53.4 | Yes | No
R1005 | R98 | R1005 | 2 | Top | 0 | 16.55 | 13.4 | Yes | No
R1005 | R99 | R1005 | 2 | Top | 270 | 20.85 | 13.4 | Yes | No
R1005 | R100 | R1005 | 2 | Top | 0 | 19 | 110.65 | Yes | No
R1005 | R101 | R1005 | 2 | Top | 180 | 25 | 110.65 | Yes | No
R1005 | R102 | R1005 | 2 | Top | 0 | 31.5 | 110.65 | Yes | No
R1608 | R103 | R1608 | 2 | Bottom | 90 | 51.65 | 19.9 | Yes | No
R1005 | R104 | R1005 | 2 | Top | 90 | 53.65 | 56.95 | Yes | No
R1005 | R105 | R1005 | 2 | Top | 90 | 56.2 | 56.95 | Yes | No
R1005 | R106 | R1005 | 2 | Top | 270 | 54.8 | 47.15 | Yes | No
R1608 | R107 | R1608 | 2 | Top | 0 | 25.7 | 64.3 | Yes | No
R1608 | R108 | R1608 | 2 | Top | 90 | 35.2 | 65.6 | Yes | No
R1608 | R109 | R1608 | 2 | Top | 90 | 33.75 | 65.6 | Yes | No
R1608 | R110 | R1608 | 2 | Top | 90 | 55.1 | 69.3 | Yes | No
R1608 | R111 | R1608 | 2 | Top | 90 | 53.65 | 69.3 | Yes | No
R1608 | R112 | R1608 | 2 | Top | 90 | 79.8 | 69.15 | Yes | No
R1608 | R113 | R1608 | 2 | Bottom | 180 | 30.858 | 79.385 | Yes | No
R1608 | R114 | R1608 | 2 | Bottom | 90 | 16.7 | 34.7 | Yes | No
L1005(0402) | RV1 | L1005(0402) | 2 | Top | 270 | 111.75 | 45.9 | Yes | No
L1005(0402) | RV2 | L1005(0402) | 2 | Top | 270 | 111.75 | 26.9 | Yes | No
L1005(0402) | RV3 | L1005(0402) | 2 | Top | 270 | 111.75 | 17.4 | Yes | No
L1005(0402) | RV4 | L1005(0402) | 2 | Top | 270 | 111.75 | 36.4 | Yes | No
SW4P_1102_DIP | S1 | SW4P_1102_DIP | 4 | Top | 0 | 14 | 115 | No | No
SW4P_1102_DIP | S2 | SW4P_1102_DIP | 4 | Top | 0 | 23.5 | 115 | No | No
SW4P_1102_DIP | S3 | SW4P_1102_DIP | 4 | Top | 0 | 33 | 115 | No | No
TP | TP1 | TP | 1 | Top | 180 | 36 | 101 | Yes | No
TP | TP2 | TP | 1 | Top | 180 | 37.6 | 90.05 | Yes | No
TP | TP3 | TP | 1 | Top | 0 | 76.2 | 27.6 | Yes | No
TP | TP4 | TP | 1 | Top | 0 | 72.9 | 27.5 | Yes | No
TP | TP5 | TP | 1 | Top | 0 | 79.95 | 23.25 | Yes | No
TP | TP6 | TP | 1 | Top | 0 | 76.9 | 27.6 | Yes | No
TP | TP7 | TP | 1 | Top | 0 | 11.7 | 54.75 | Yes | No
TP | TP8 | TP | 1 | Top | 0 | 15.5 | 54.65 | Yes | No
TSOT23-6 | U1 | TSOT23-6 | 6 | Top | 90 | 22.25 | 107.5 | Yes | No
UMLP_0.4_1.4X1.8 | U2 | UMLP_0.4_1.4X1.8 | 10 | Bottom | 90 | 9.25 | 81.5 | Yes | No
WDFN12(0.45MM_3X3) | U3 | WDFN12(0.45MM_3X3) | 13 | Top | 180 | 36.5 | 96.55 | Yes | No
SOT23-5P | U4 | SOT23-5P | 5 | Top | 270 | 62 | 11.7 | Yes | No
SOT23 | U5 | SOT23 | 3 | Bottom | 90 | 87.4 | 77.7 | Yes | No
VQFN16-4X3.5 | U6 | VQFN16-4X3.5 | 17 | Top | 270 | 60 | 82.25 | Yes | No
VQFN16-4X3.5 | U7 | VQFN16-4X3.5 | 17 | Top | 90 | 60 | 43 | Yes | No
SC70-5 | U8 | SC70-5 | 5 | Top | 270 | 99.325 | 46.1 | Yes | No
SC70-5 | U9 | SC70-5 | 5 | Top | 270 | 99.325 | 27.1 | Yes | No
SC70-5 | U10 | SC70-5 | 5 | Top | 270 | 99.325 | 17.6 | Yes | No
SC70-5 | U11 | SC70-5 | 5 | Top | 270 | 99.325 | 36.6 | Yes | No
QFN48_4_6X6 | U12 | QFN48_4_6X6 | 49 | Top | 270 | 75.1 | 22.8 | Yes | No
SC70-6 | U13 | SC70-6 | 6 | Top | 90 | 24 | 22 | Yes | No
SC59 | U14 | SC59 | 3 | Top | 90 | 71.15 | 103.2 | Yes | No
WLCSP9_1.14X1.14 | U15 | WLCSP9_1.14X1.14 | 9 | Top | 0 | 75.8 | 104.75 | Yes | No
DUAL_USB_A | U16 | DUAL_USB_A | 12 | Bottom | 90 | 104.5 | 84 | No | No
SOIC8 | U17 | SOIC8 | 8 | Top | 270 | 95 | 83.25 | Yes | No
DUAL_USB_A | U18 | DUAL_USB_A | 12 | Bottom | 90 | 104.5 | 65 | No | No
SOIC8 | U19 | SOIC8 | 8 | Top | 270 | 95 | 64.75 | Yes | No
IC_QFN64_0.5P_9X9_LAN9514 | U20 | IC_QFN64_0.5P_9X9_LAN9514 | 65 | Bottom | 90 | 85.7 | 91.3 | Yes | No
RJ45_LU1T041X-43LF | U21 | RJ45_LU1T041X-43LF | 16 | Bottom | 90 | 109.25 | 101 | No | No
SOIC8 | U22 | SOIC8 | 8 | Top | 0 | 13.6 | 59.75 | Yes | No
SOIC8 | U23 | SOIC8 | 8 | Top | 180 | 51 | 19.5 | Yes | No
WSON8_127_6X5 | U24 | WSON8_127_6X5 | 9 | Top | 270 | 54.25 | 52 | Yes | No
OSC3225 | X1 | OSC3225 | 4 | Top | 0 | 66 | 21.35 | Yes | No
OSC3225 | X2 | OSC3225 | 4 | Bottom | 90 | 96.9 | 89.1 | Yes | No
CRYSTAL_6020 | X3 | CRYSTAL_6020 | 3 | Top | 0 | 52.25 | 25.75 | Yes | No
HOLE3.5-NTH | $MH1 | HOLE3.5-NTH | 1 | Top | 0 | 5 | 5 | No | No
HOLE3.5-NTH | $MH2 | HOLE3.5-NTH | 1 | Top | 0 | 115 | 5 | No | No
HOLE3.5-NTH | $MH3 | HOLE3.5-NTH | 1 | Top | 0 | 5 | 115 | No | No
HOLE3.5-NTH | $MH4 | HOLE3.5-NTH | 1 | Top | 0 | 115 | 115 | No | No
