leesanghun-droid/A-project/3D/MIC_MODULE.step

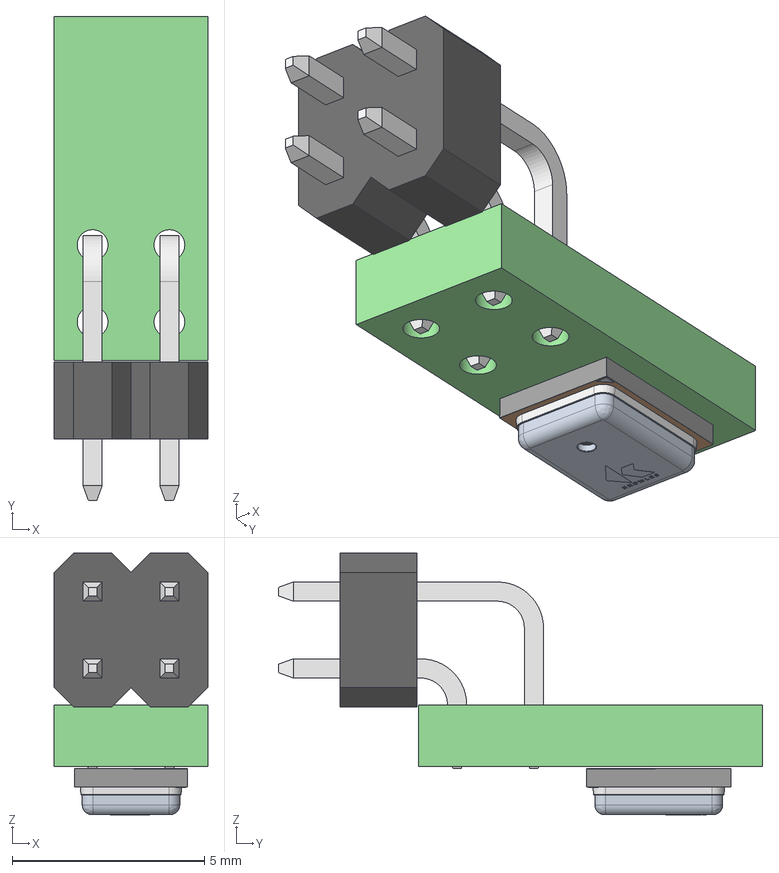
[picture p13: CAD file, 2023-02-12]
3D/MIC_MODULE.step
4.00 x 12.6 x 6.81 mm
_autosave-audio PCB
