leesanghun-droid/A-project/DC-005.STEP

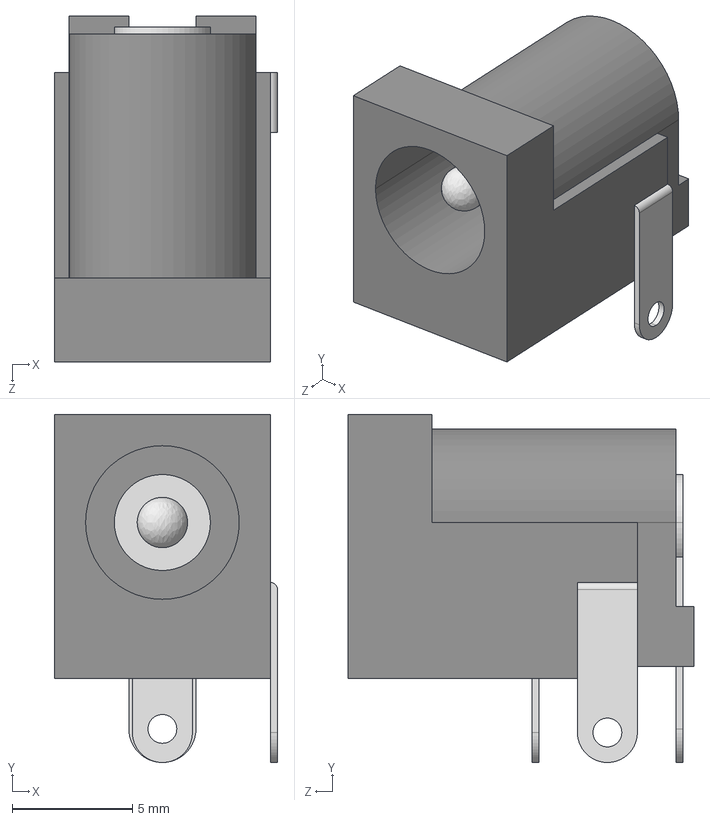
[picture p14: CAD file, 2023-02-18]
DC-005.STEP
9.30 x 14.5 x 14.4 mm
