leesanghun-droid/A-project/3D/2pin_header.stp

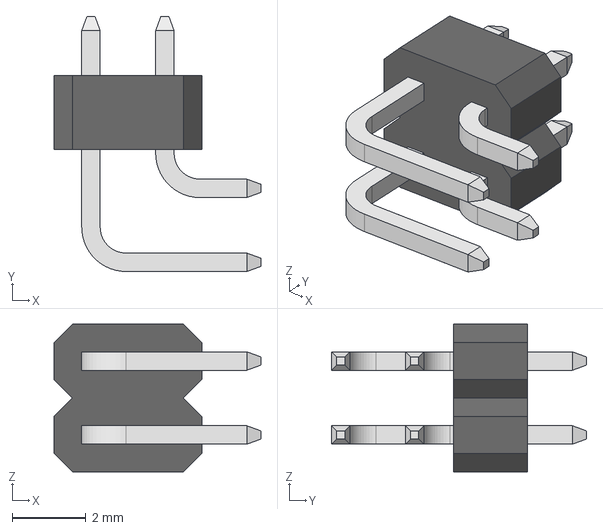
[picture p15: CAD file, 2023-02-12]
3D/2pin_header.stp
5.60 x 6.90 x 4.00 mm
