leesanghun-droid/A-project/(list of files, cad)

Other CAD files:
3D/2pin_header.ipt
