leesanghun-droid/A-project/참고자료/오디오 회로도.pdf

# AUDIO IN

마이크간 거리 | 유지 정사각형 12cm | ( | )

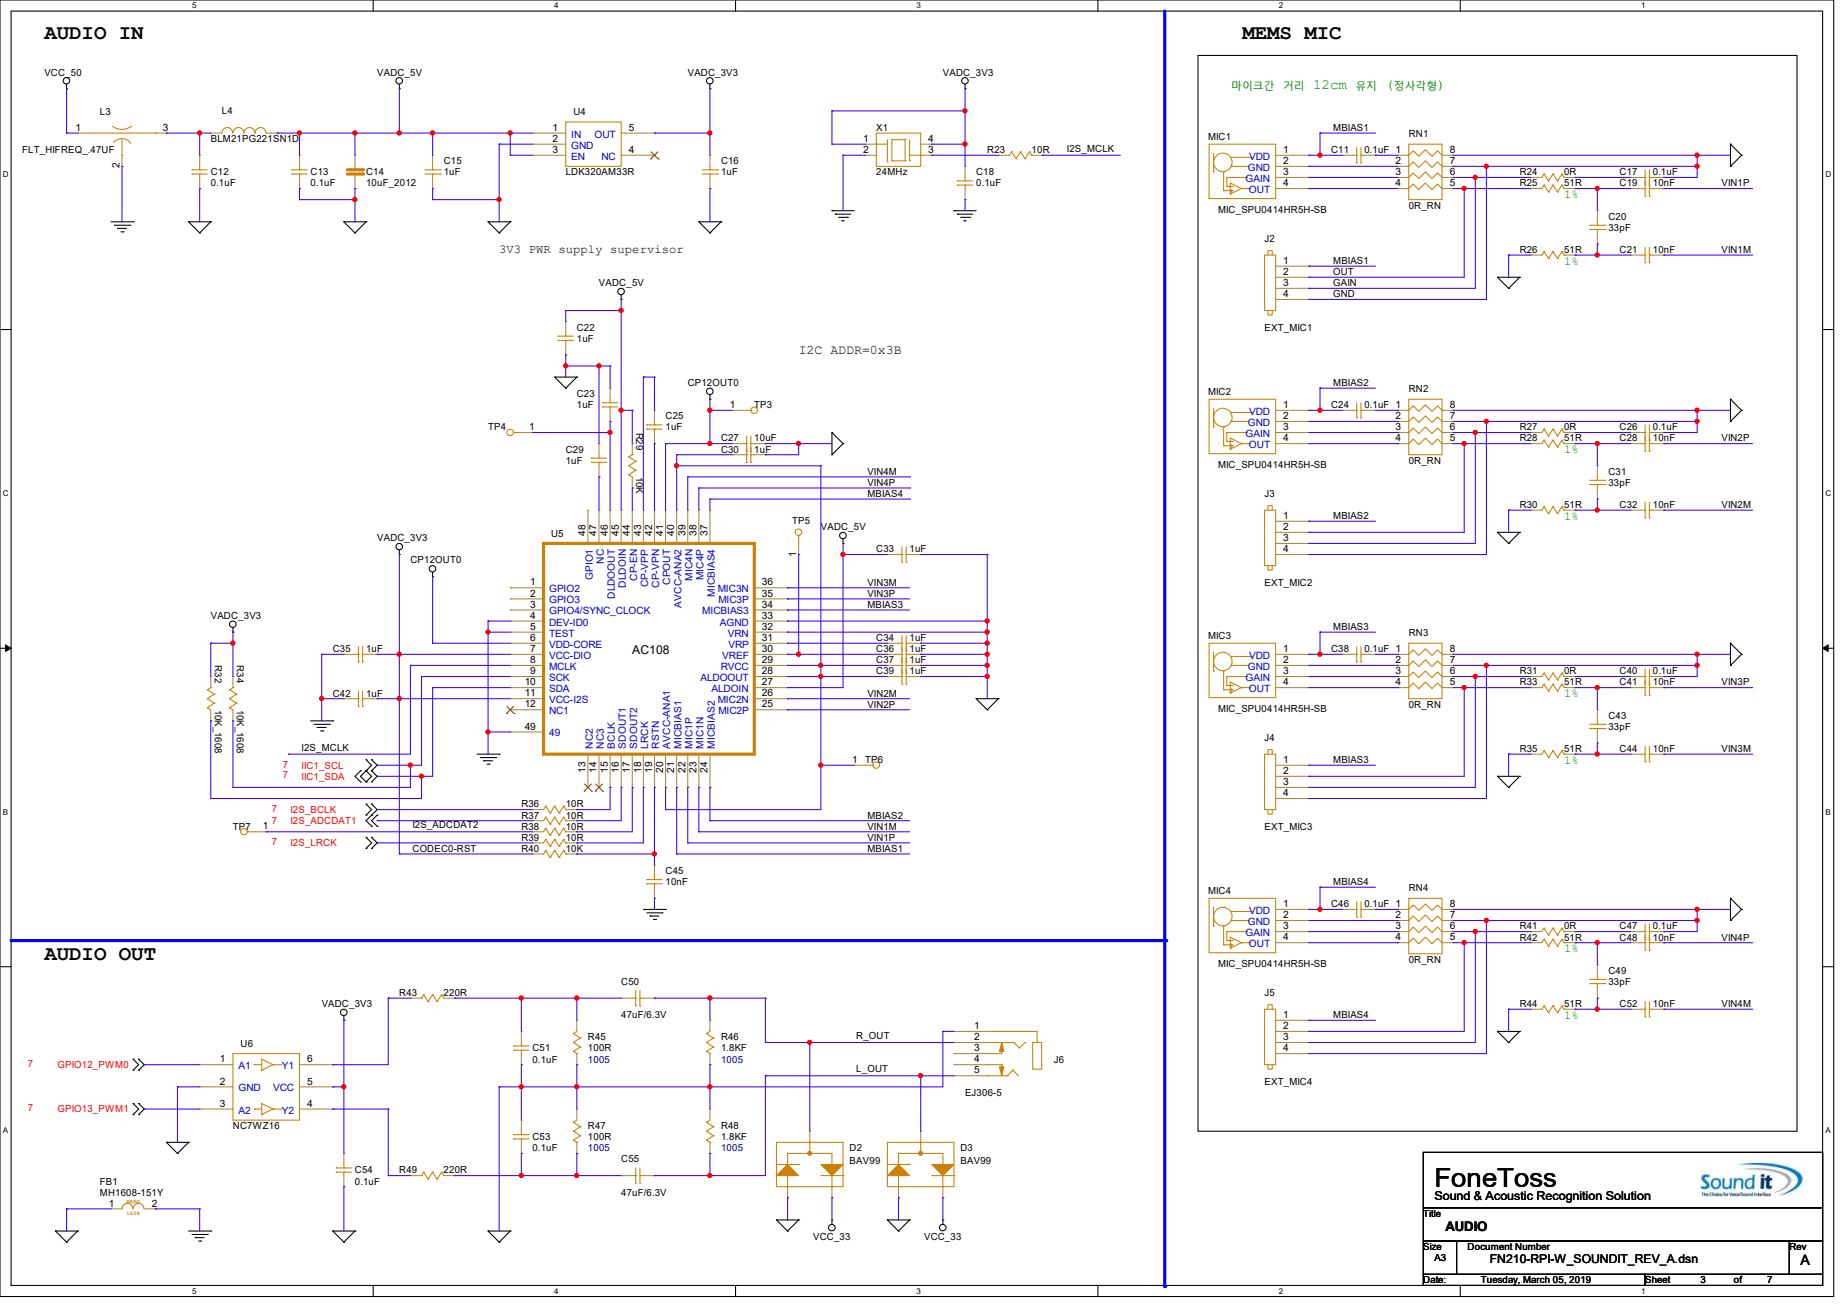
[picture p16: page 1]

VADC_5V 3V3 PWR supply supervisor | MEMS MIC VCC_50

VDD 1 GND 2 GAIN 3 OUT 4

Sound & Acoustic Recognition Solution
