leesanghun-droid/A-project/참고자료/FN200-RPI-CM_REV_A(180608)PDF-1A.pdf

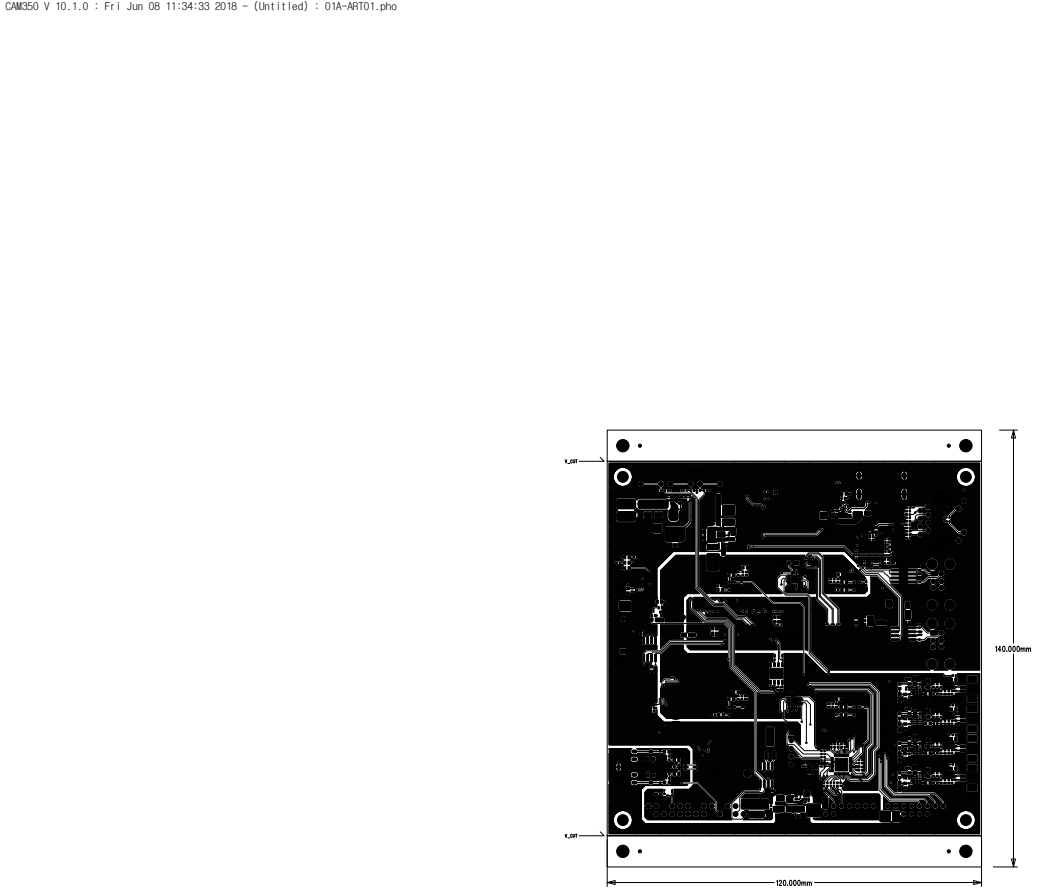
[picture p17: page 1]

CAM350 V 10.1.0 : Fri Jun 08 11:34:33 2018 - (Untitled) : 01A-ART01.pho

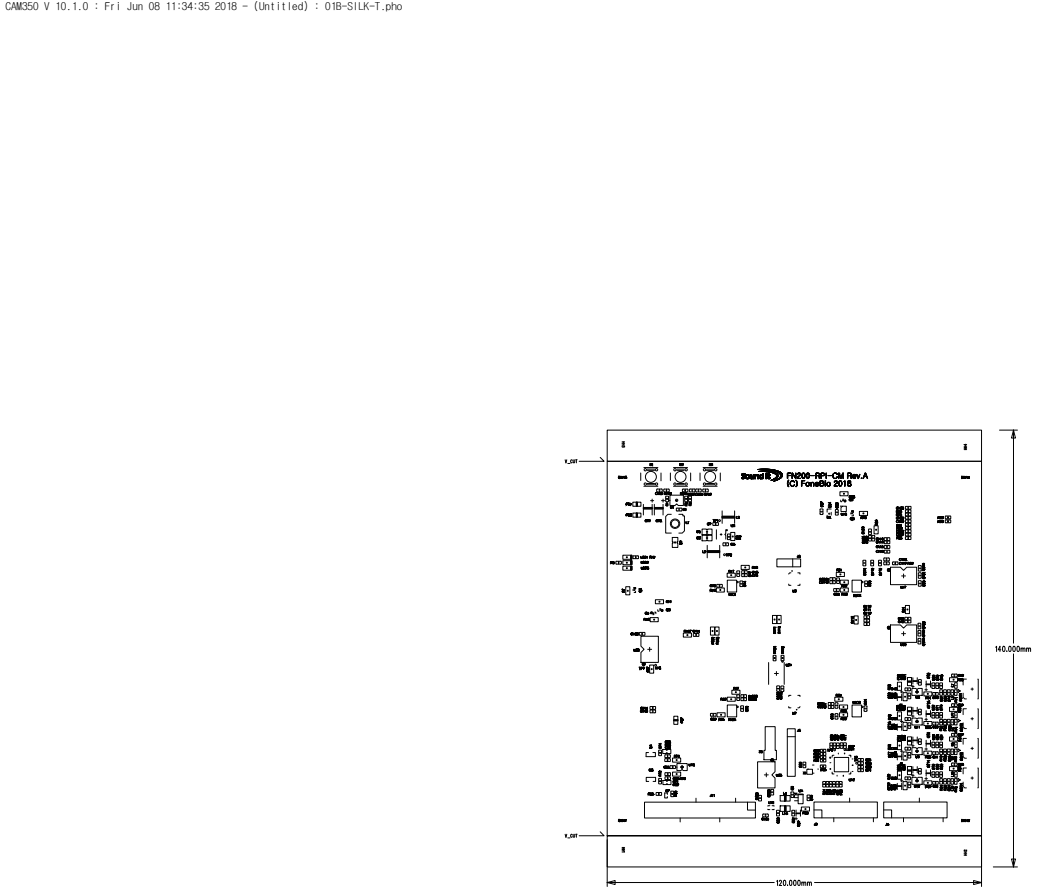
[picture p18: page 2]

CAM350 V 10.1.0 : Fri Jun 08 11:34:35 2018 - (Untitled) : 01B-SILK-T.pho

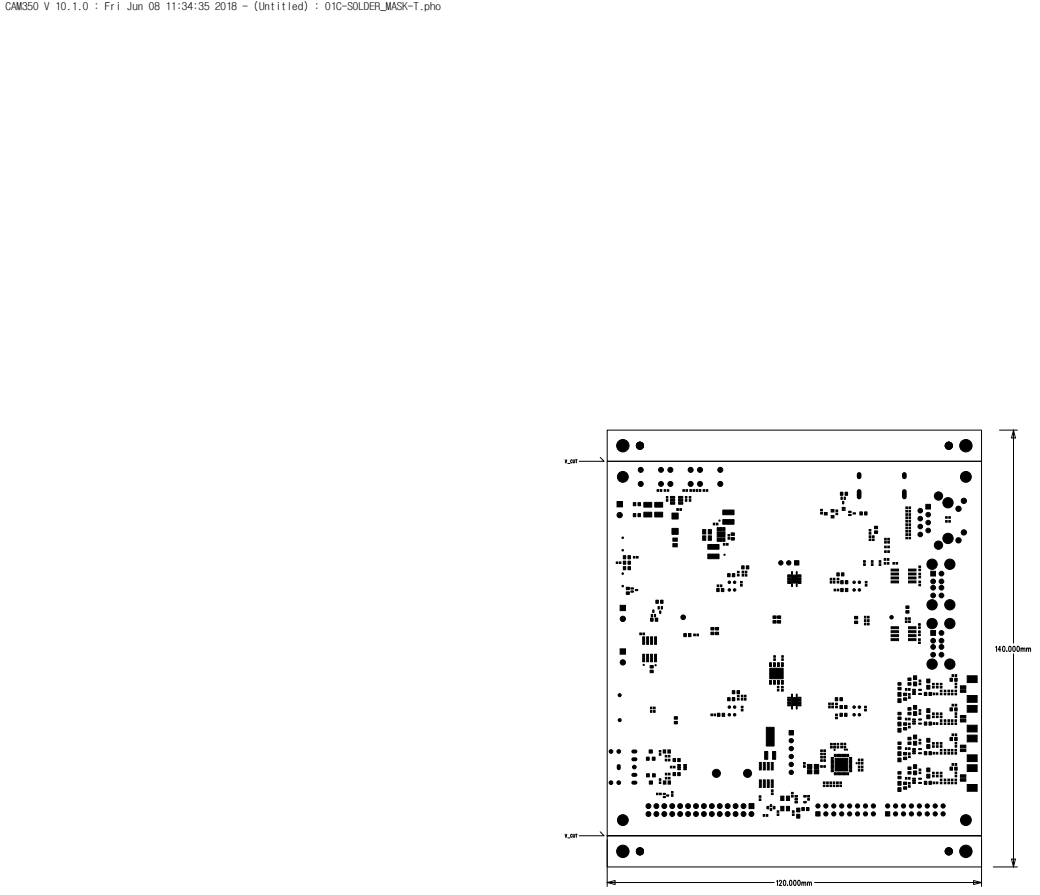
[picture p19: page 3]

CAM350 V 10.1.0 : Fri Jun 08 11:34:35 2018 - (Untitled) : 01C-SOLDER_MASK-T.pho

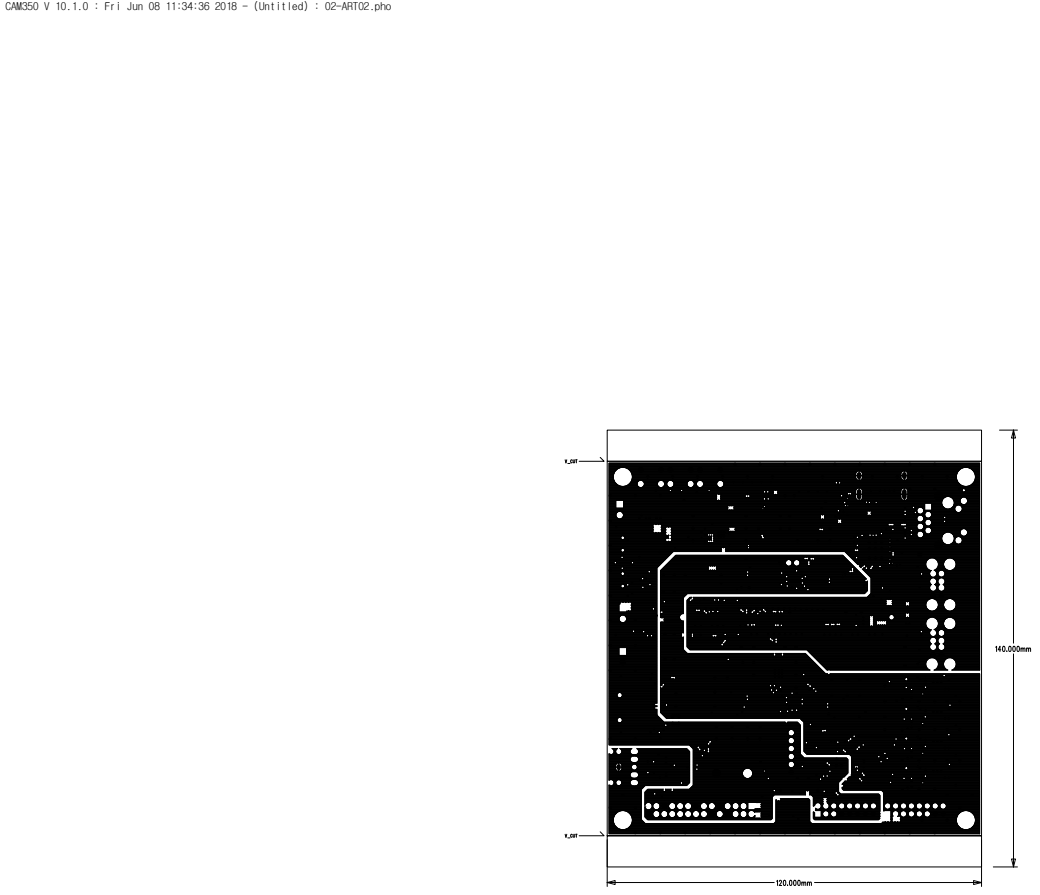
[picture p20: page 4]

CAM350 V 10.1.0 : Fri Jun 08 11:34:36 2018 - (Untitled) : 02-ART02.pho

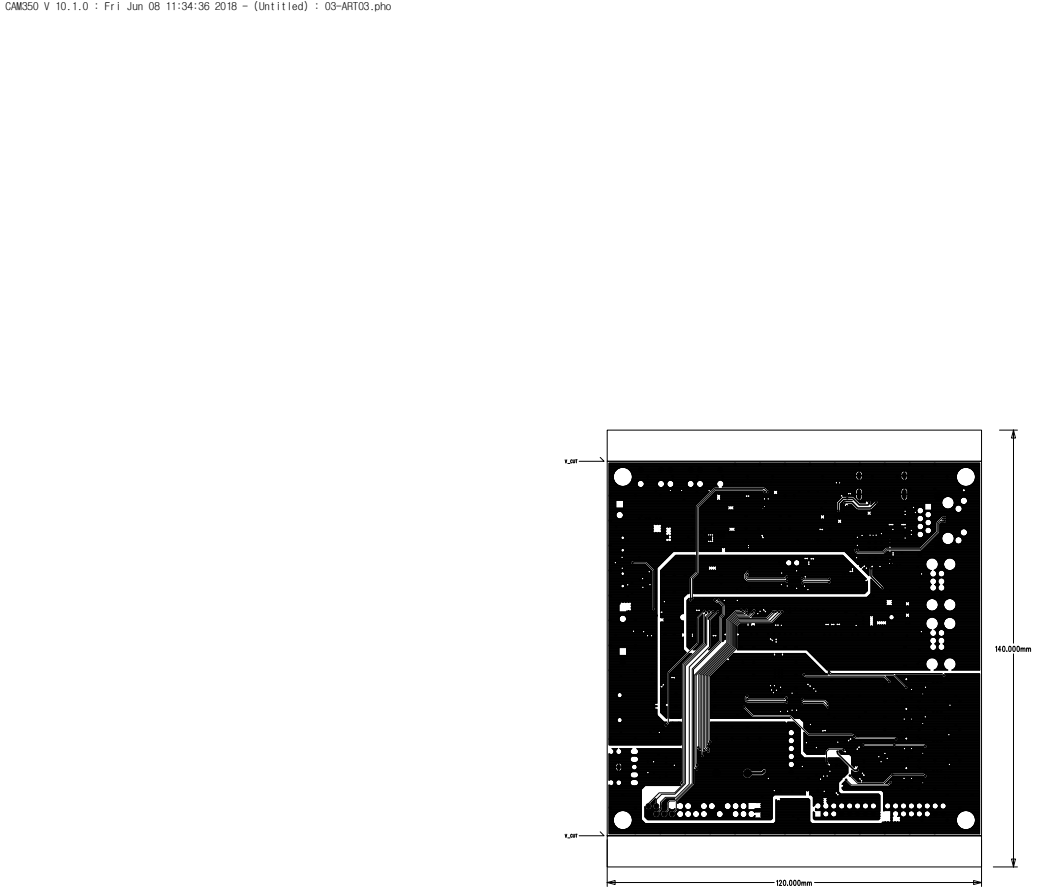
[picture p21: page 5]

CAM350 V 10.1.0 : Fri Jun 08 11:34:36 2018 - (Untitled) : 03-ART03.pho

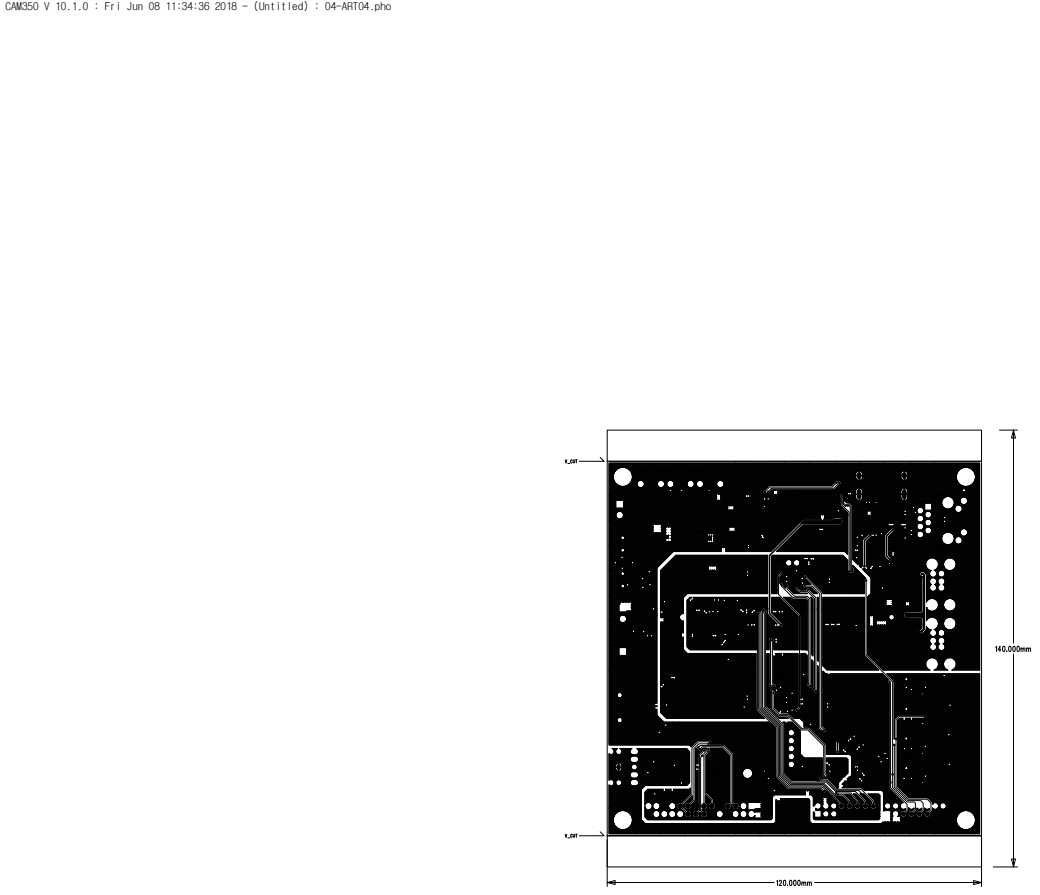
[picture p22: page 6]

CAM350 V 10.1.0 : Fri Jun 08 11:34:36 2018 - (Untitled) : 04-ART04.pho

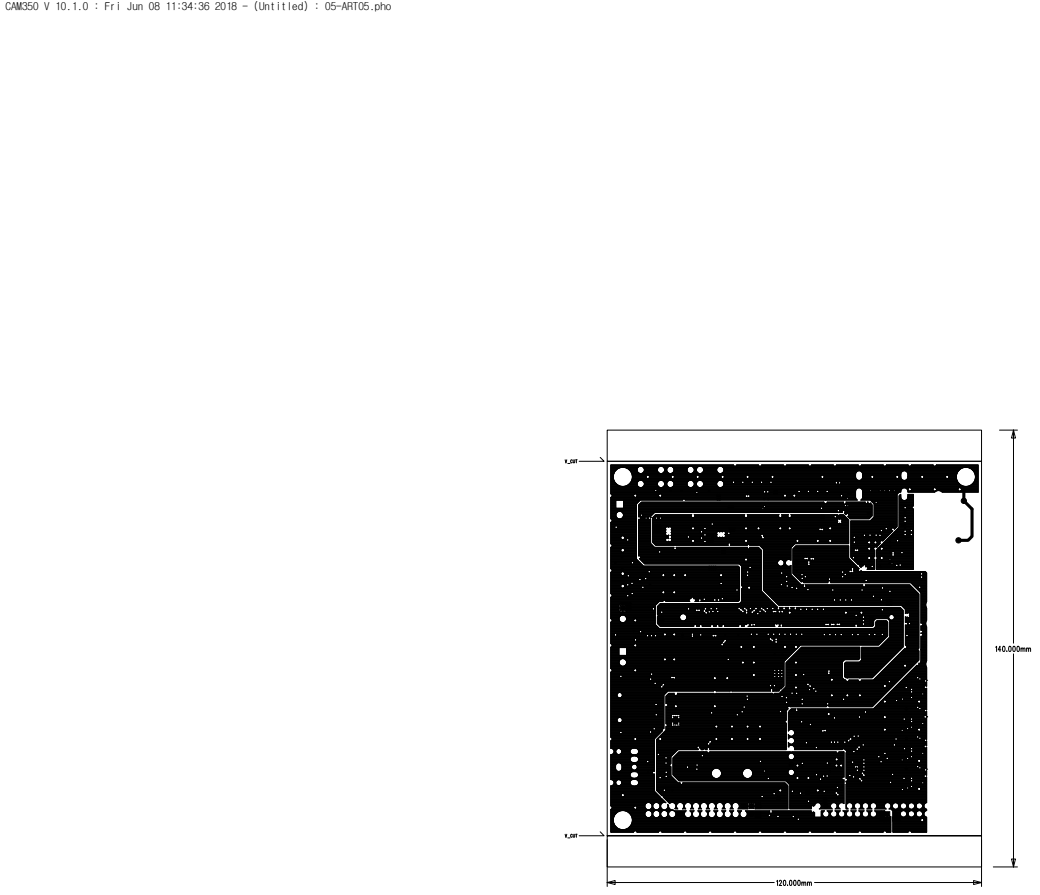
[picture p23: page 7]

CAM350 V 10.1.0 : Fri Jun 08 11:34:36 2018 - (Untitled) : 05-ART05.pho

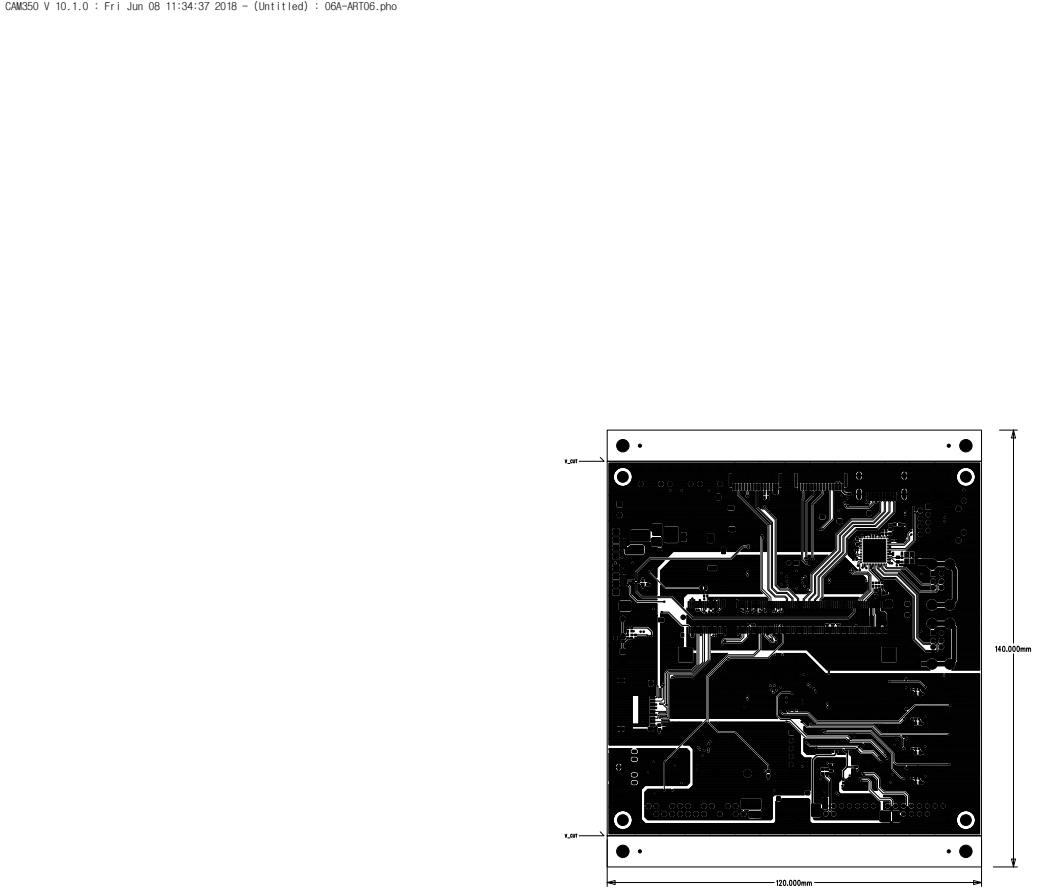
[picture p24: page 8]

CAM350 V 10.1.0 : Fri Jun 08 11:34:37 2018 - (Untitled) : 06A-ART06.pho

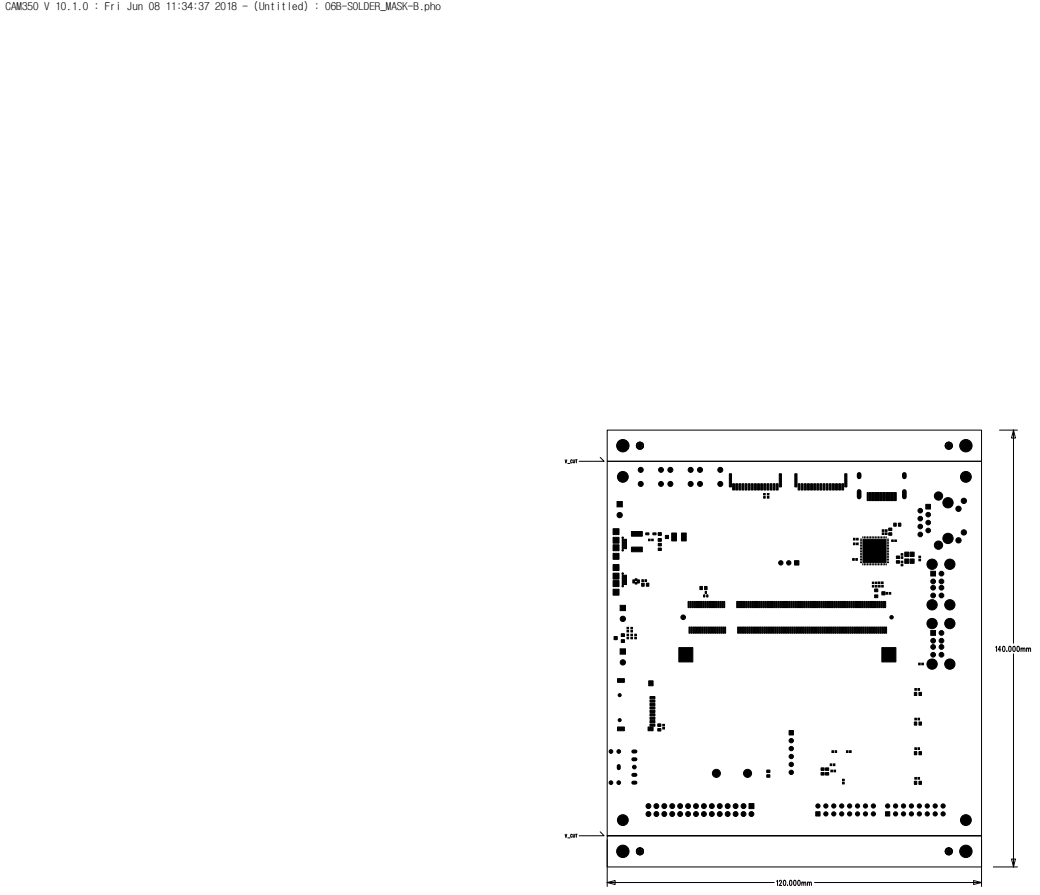
[picture p25: page 9]

CAM350 V 10.1.0 : Fri Jun 08 11:34:37 2018 - (Untitled) : 06B-SOLDER_MASK-B.pho

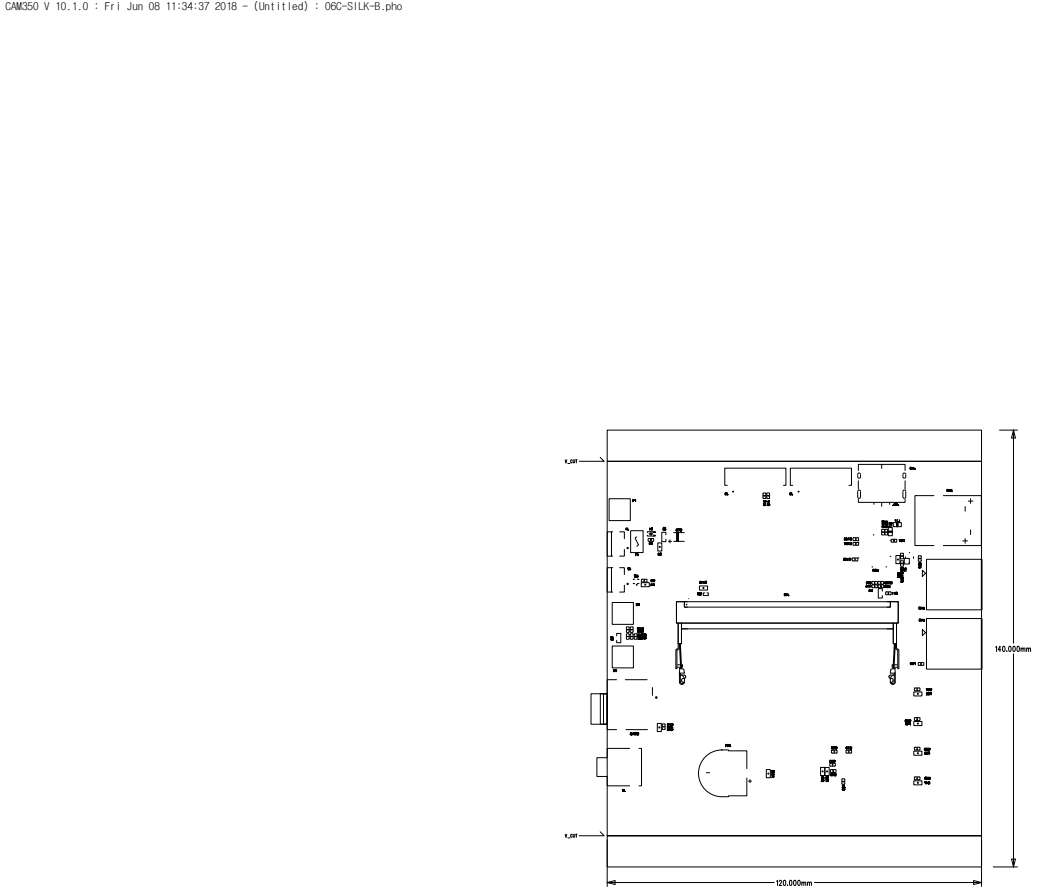
[picture p26: page 10]

CAM350 V 10.1.0 : Fri Jun 08 11:34:37 2018 - (Untitled) : 06C-SILK-B.pho

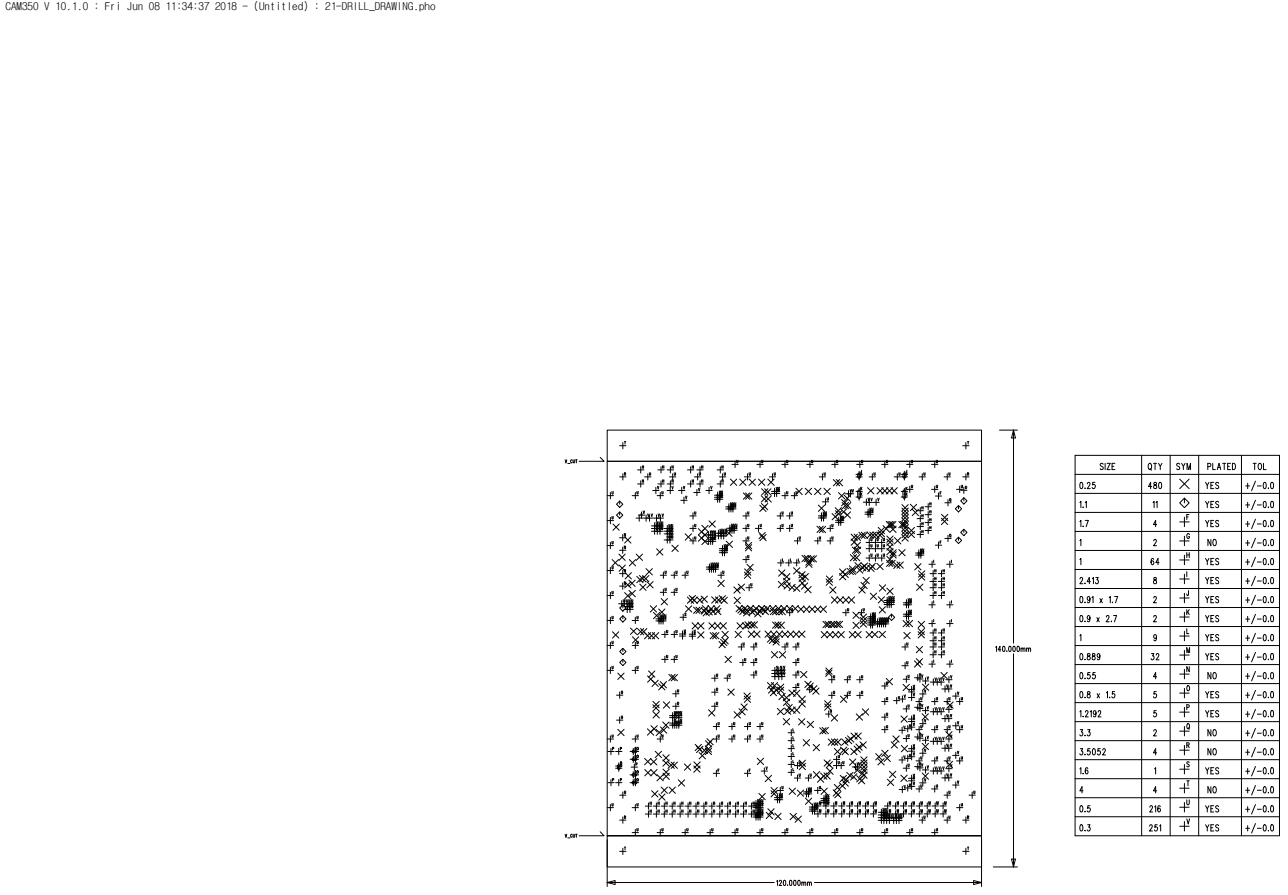
[picture p27: page 11]

CAM350 V 10.1.0 : Fri Jun 08 11:34:37 2018 - (Untitled) : 21-DRILL_DRAWING.pho

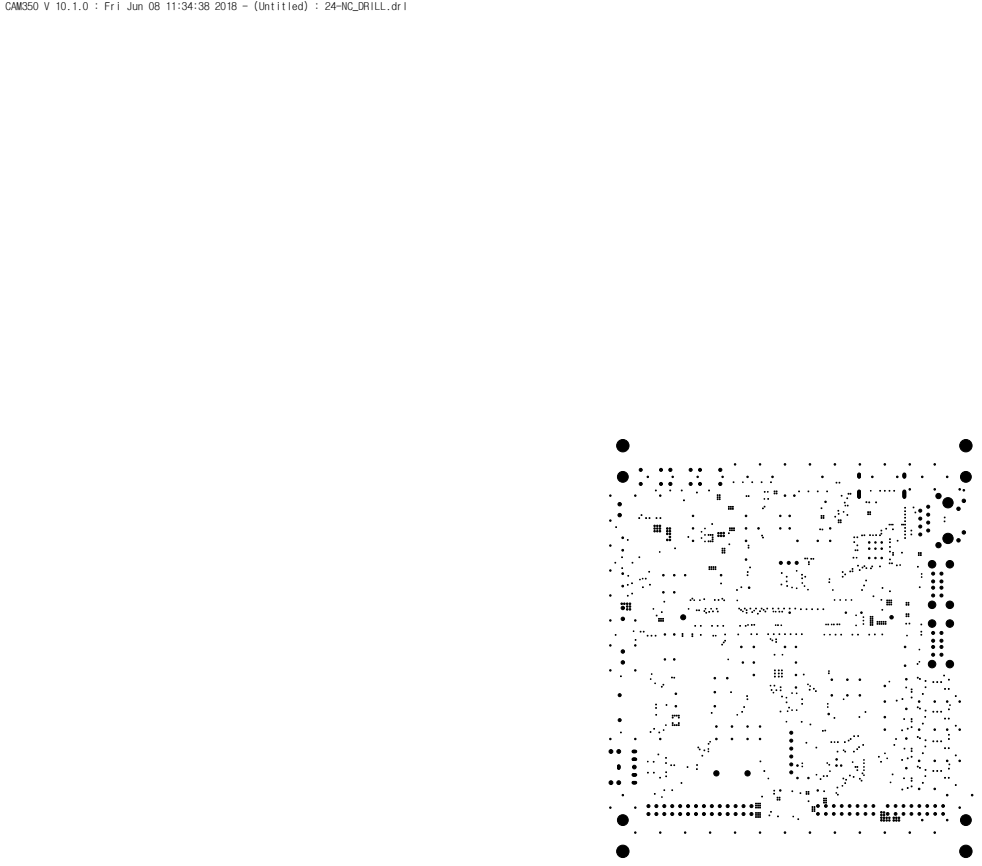
[picture p28: page 12]

CAM350 V 10.1.0 : Fri Jun 08 11:34:38 2018 - (Untitled) : 24-NC_DRILL.drl
