leesanghun-droid/A-project/참고자료/FN200-RPI-CM_REV_A1(180823)PDF-2B.pdf

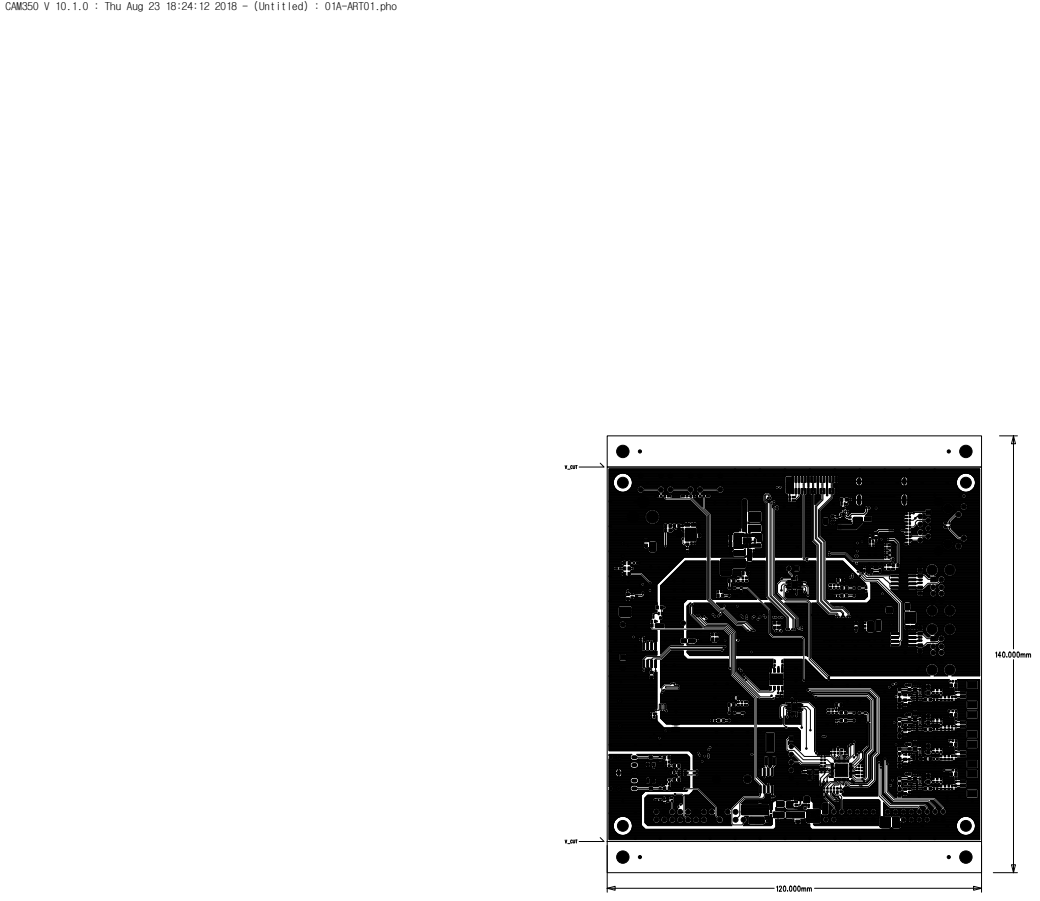
[picture p29: page 1]

CAM350 V 10.1.0 : Thu Aug 23 18:24:12 2018 - (Untitled) : 01A-ART01.pho

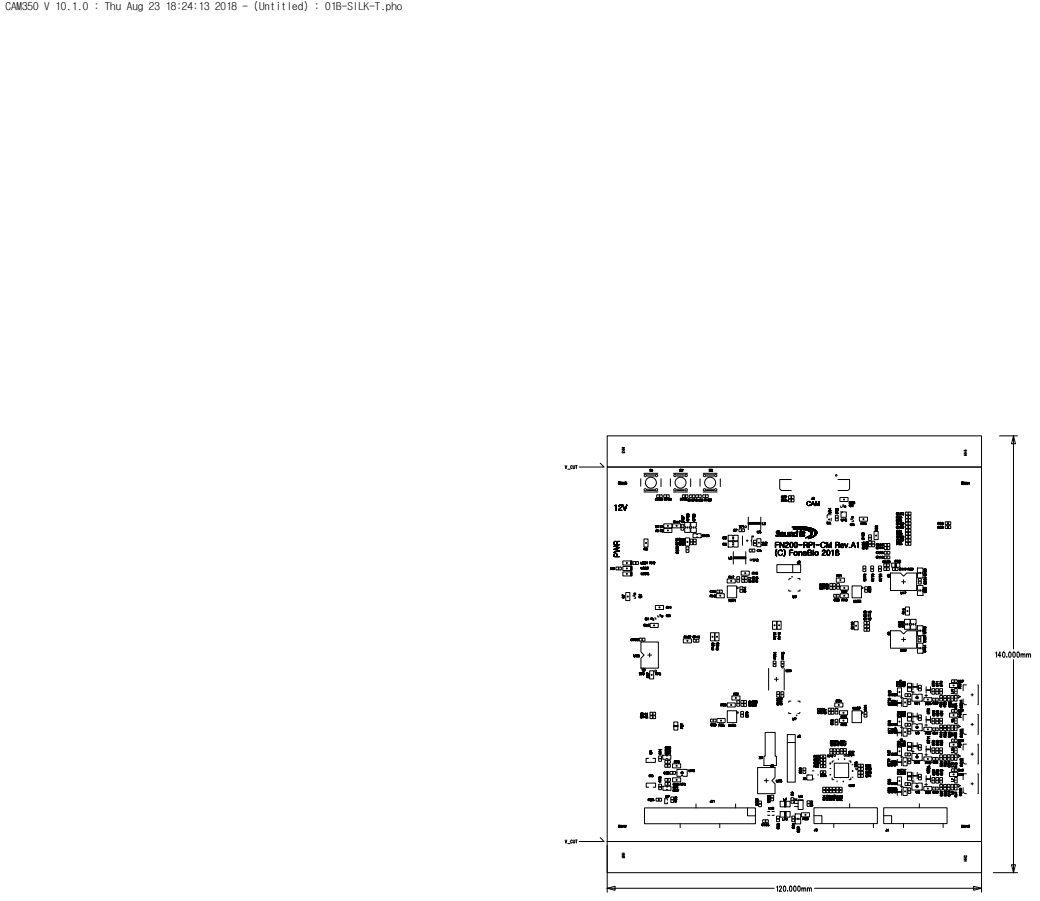
[picture p30: page 2]

CAM350 V 10.1.0 : Thu Aug 23 18:24:13 2018 - (Untitled) : 01B-SILK-T.pho

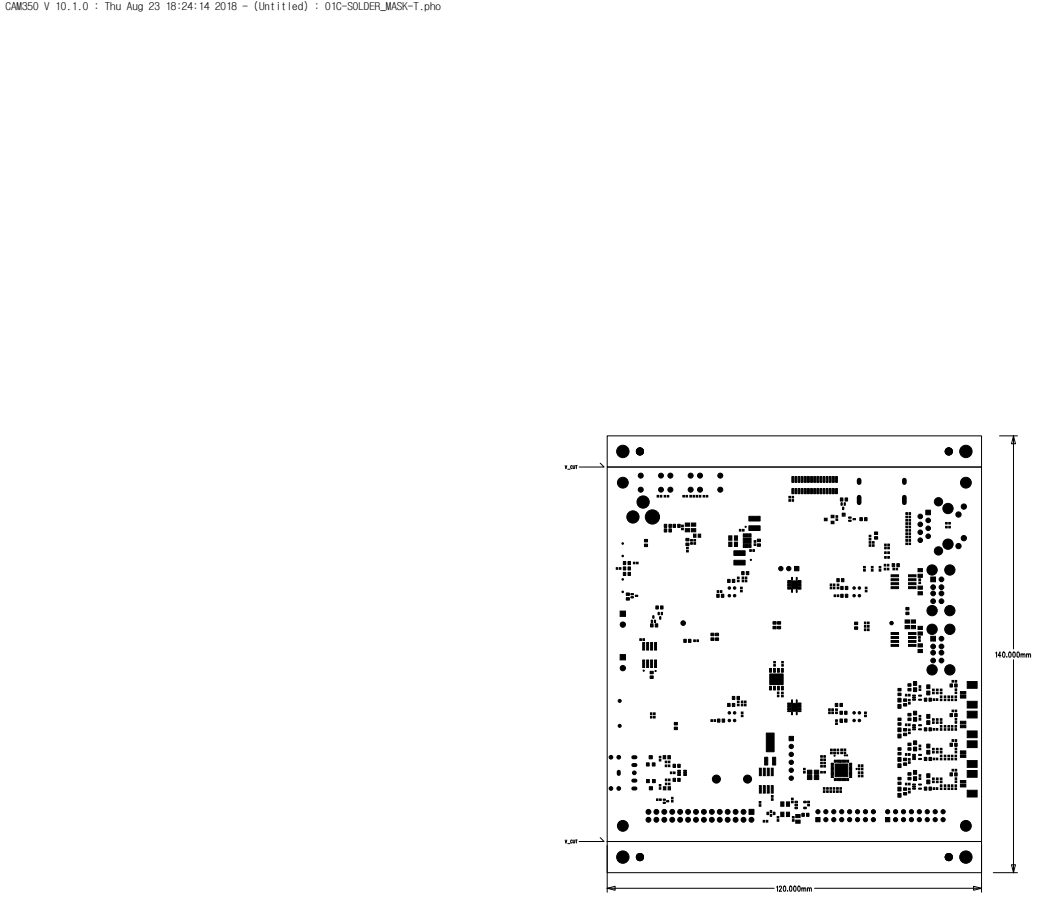
[picture p31: page 3]

CAM350 V 10.1.0 : Thu Aug 23 18:24:14 2018 - (Untitled) : 01C-SOLDER_MASK-T.pho

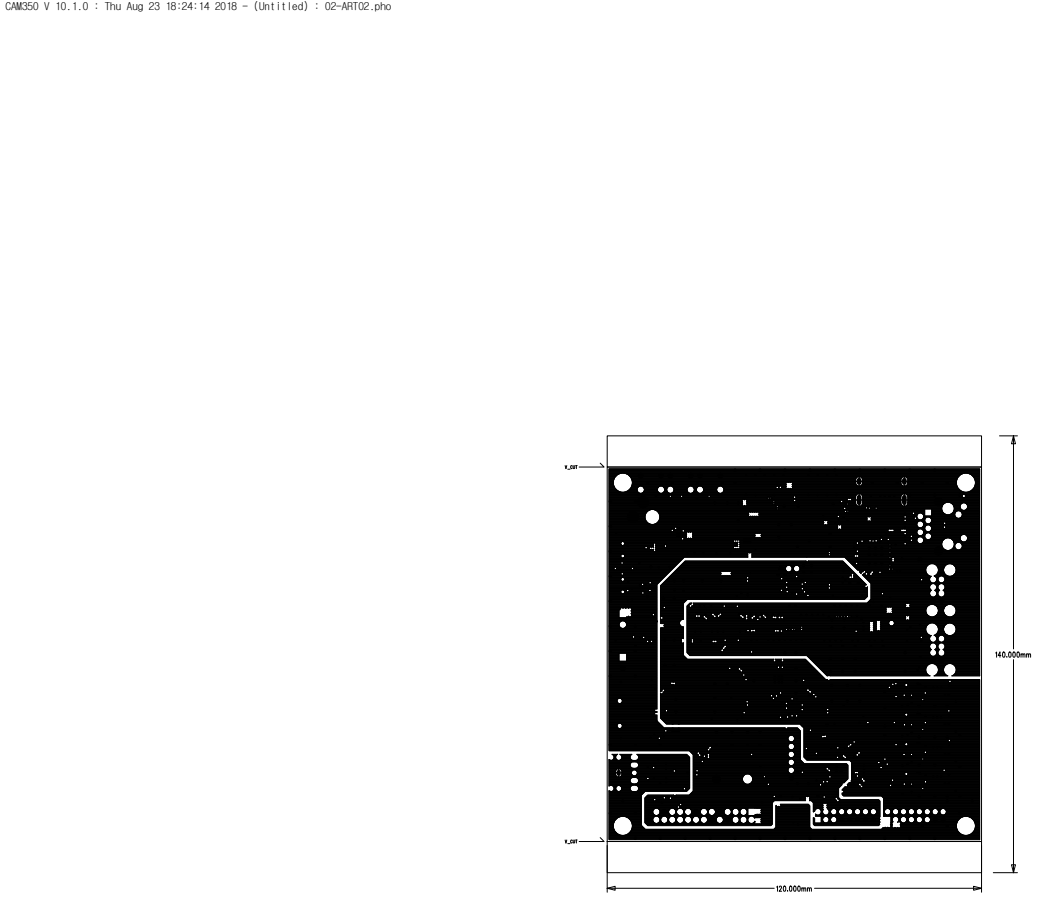
[picture p32: page 4]

CAM350 V 10.1.0 : Thu Aug 23 18:24:14 2018 - (Untitled) : 02-ART02.pho

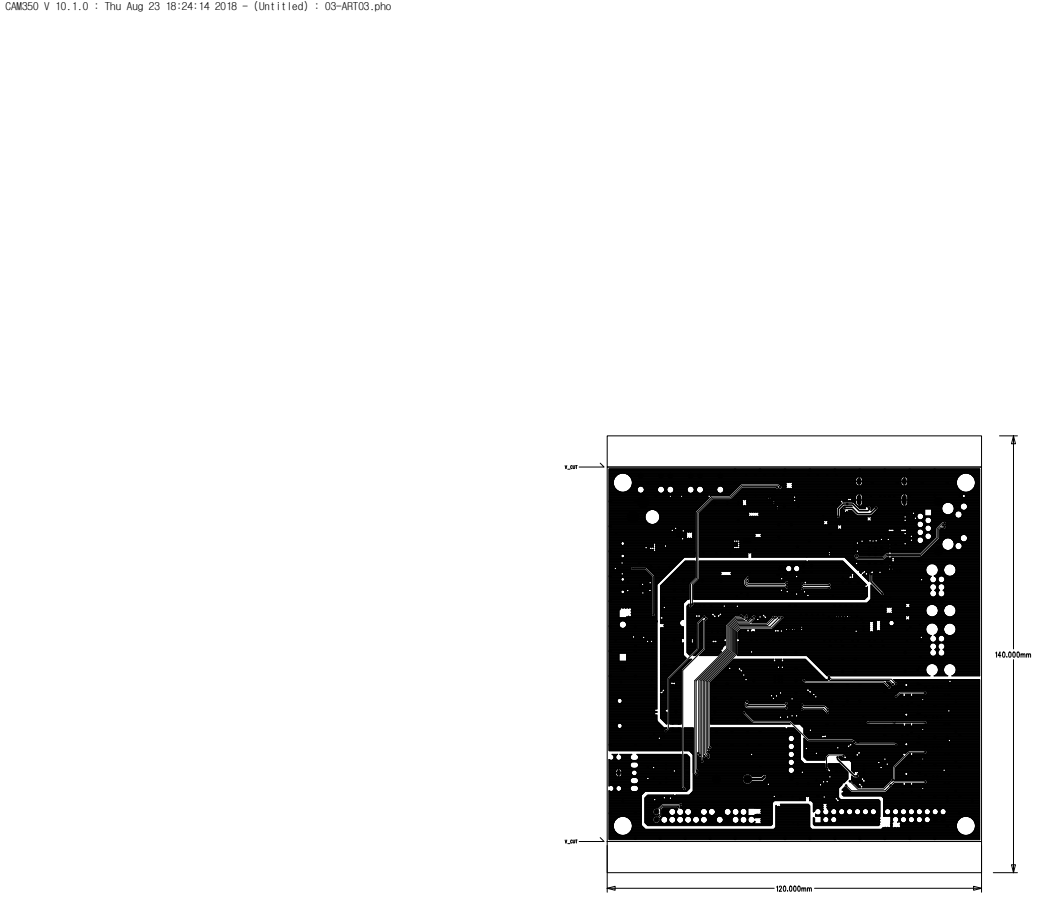
[picture p33: page 5]

CAM350 V 10.1.0 : Thu Aug 23 18:24:14 2018 - (Untitled) : 03-ART03.pho

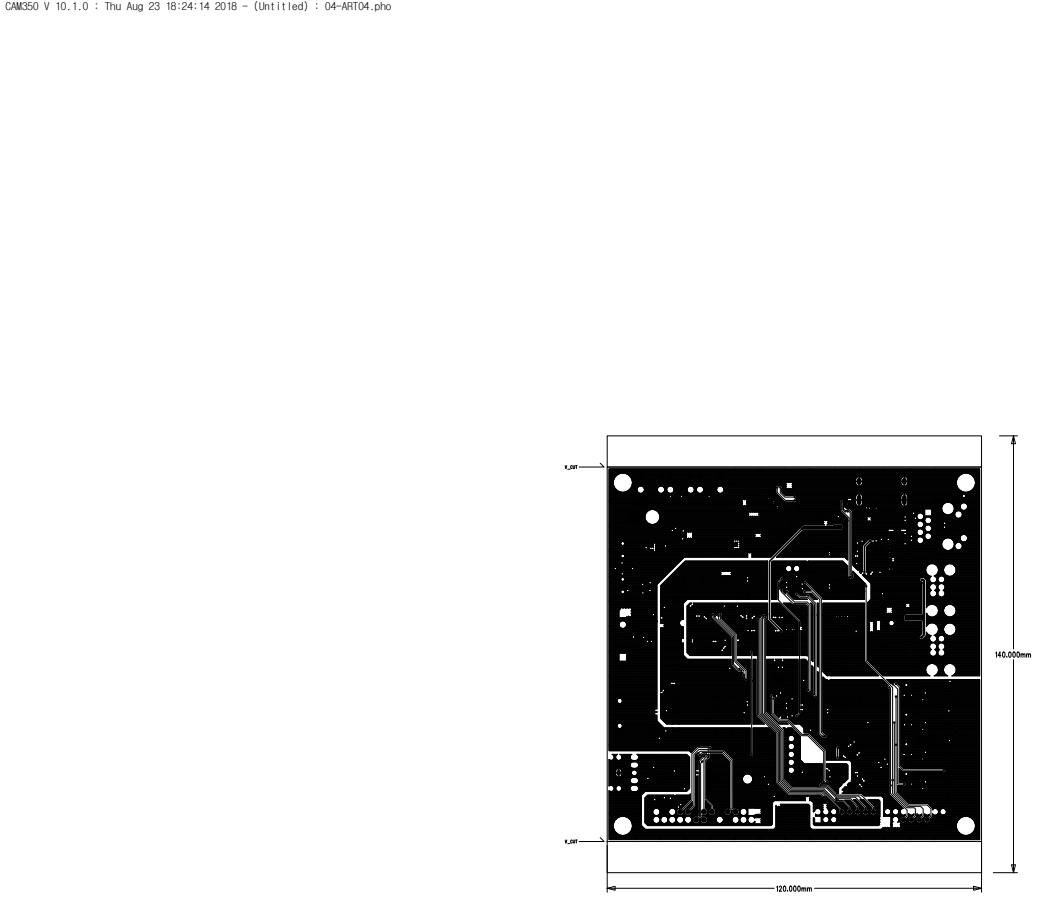
[picture p34: page 6]

CAM350 V 10.1.0 : Thu Aug 23 18:24:14 2018 - (Untitled) : 04-ART04.pho

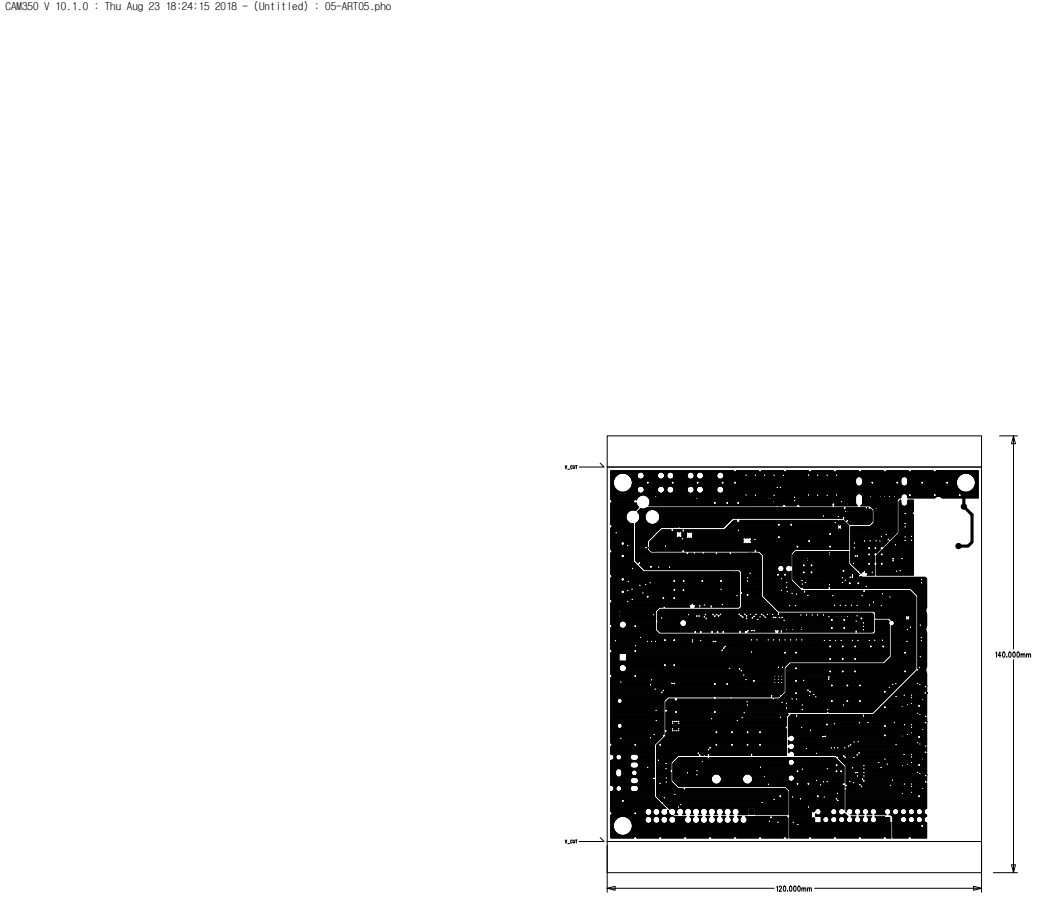
[picture p35: page 7]

CAM350 V 10.1.0 : Thu Aug 23 18:24:15 2018 - (Untitled) : 05-ART05.pho

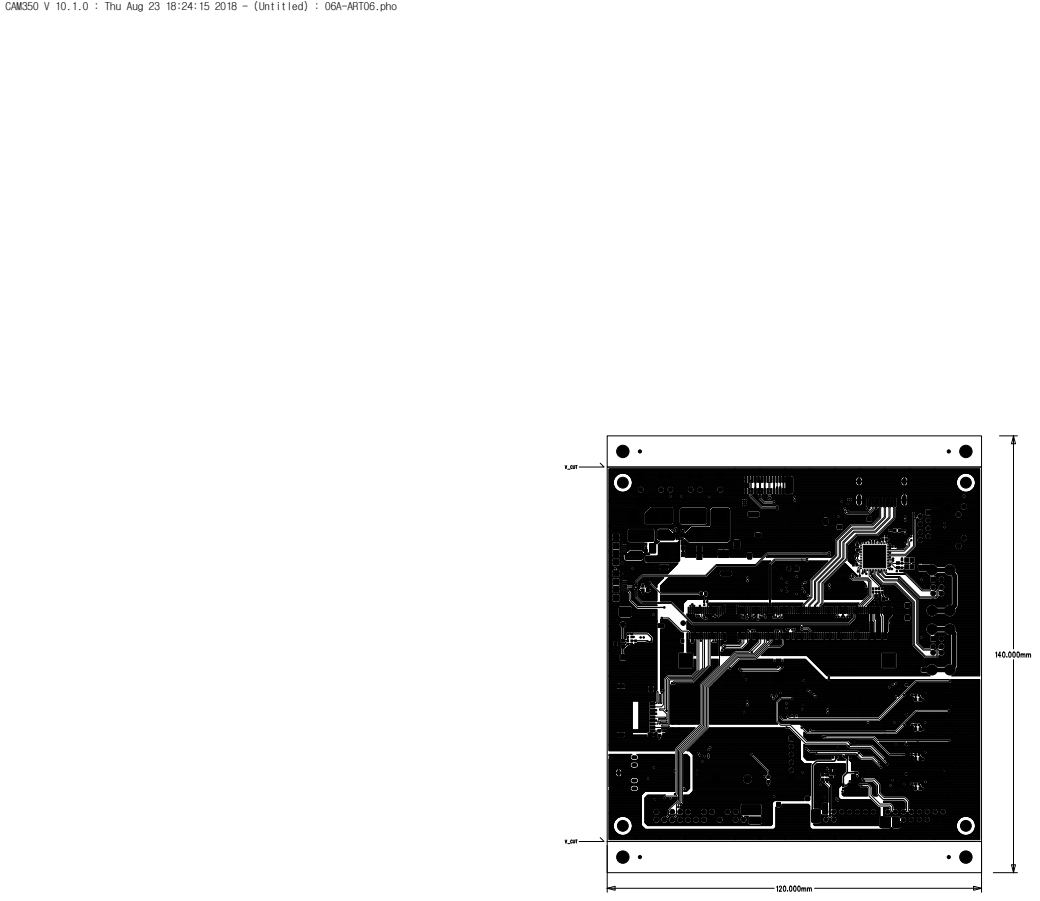
[picture p36: page 8]

CAM350 V 10.1.0 : Thu Aug 23 18:24:15 2018 - (Untitled) : 06A-ART06.pho

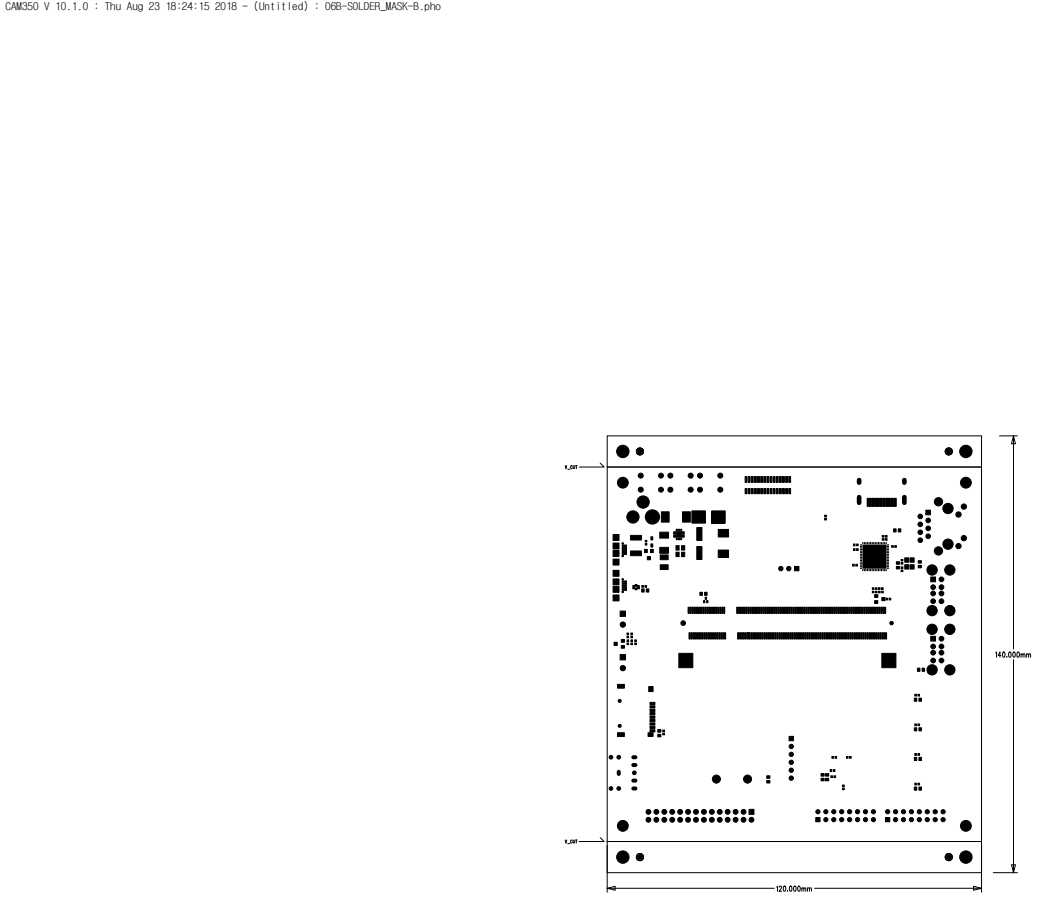
[picture p37: page 9]

CAM350 V 10.1.0 : Thu Aug 23 18:24:15 2018 - (Untitled) : 06B-SOLDER_MASK-B.pho

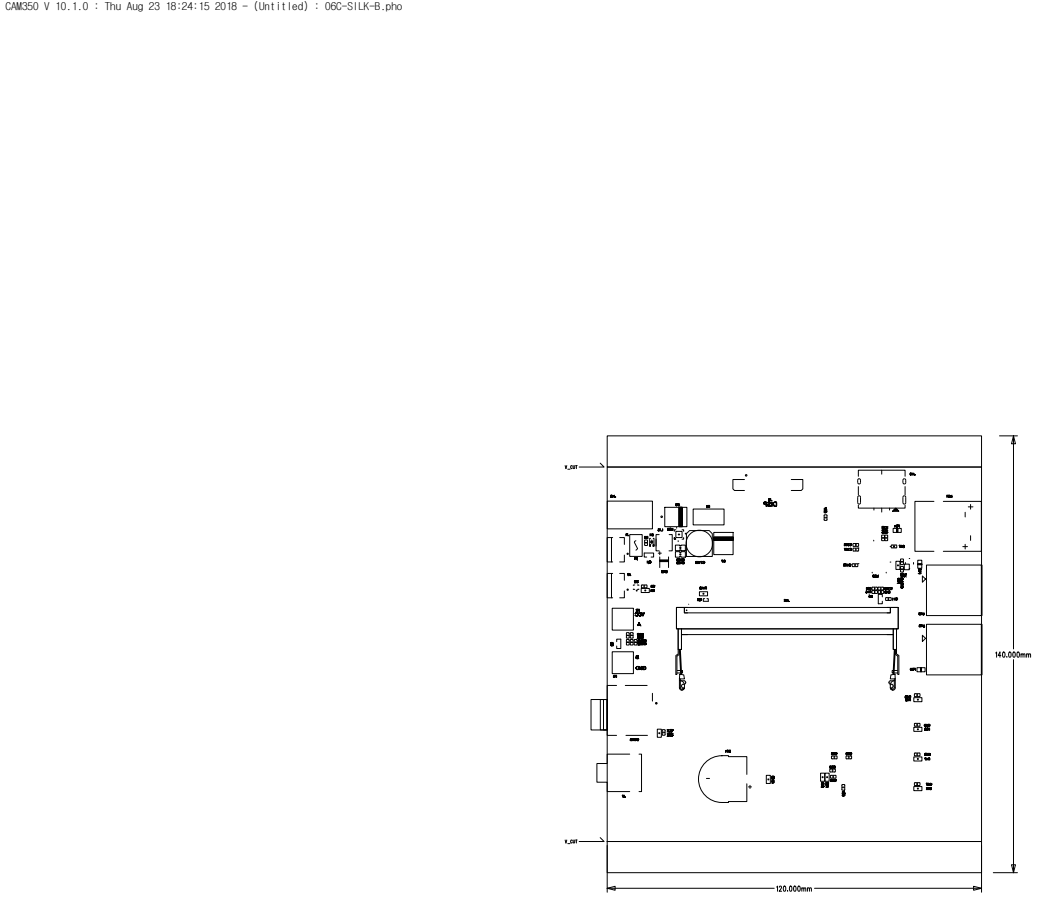
[picture p38: page 10]

CAM350 V 10.1.0 : Thu Aug 23 18:24:15 2018 - (Untitled) : 06C-SILK-B.pho

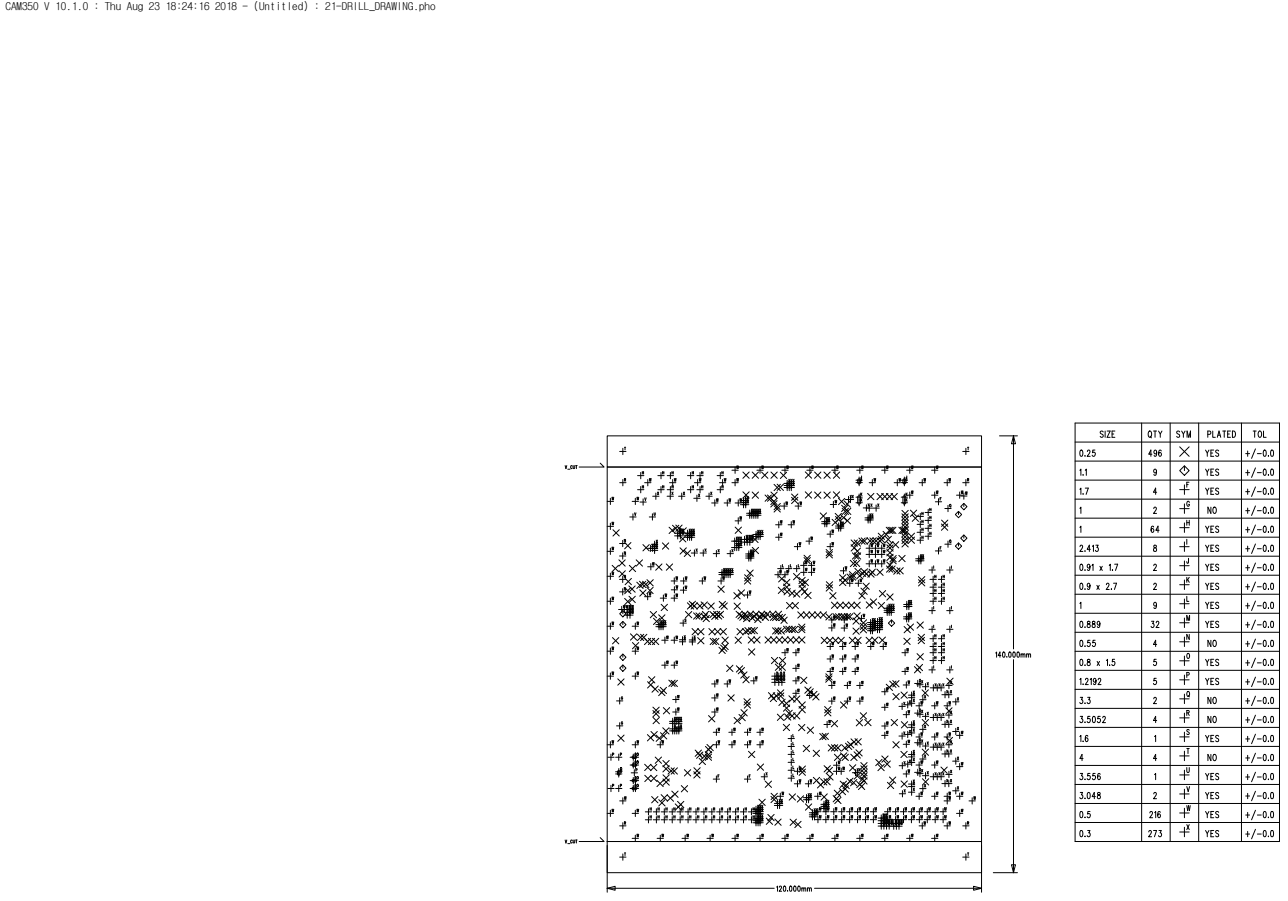
[picture p39: page 11]

CAM350 V 10.1.0 : Thu Aug 23 18:24:16 2018 - (Untitled) : 21-DRILL_DRAWING.pho

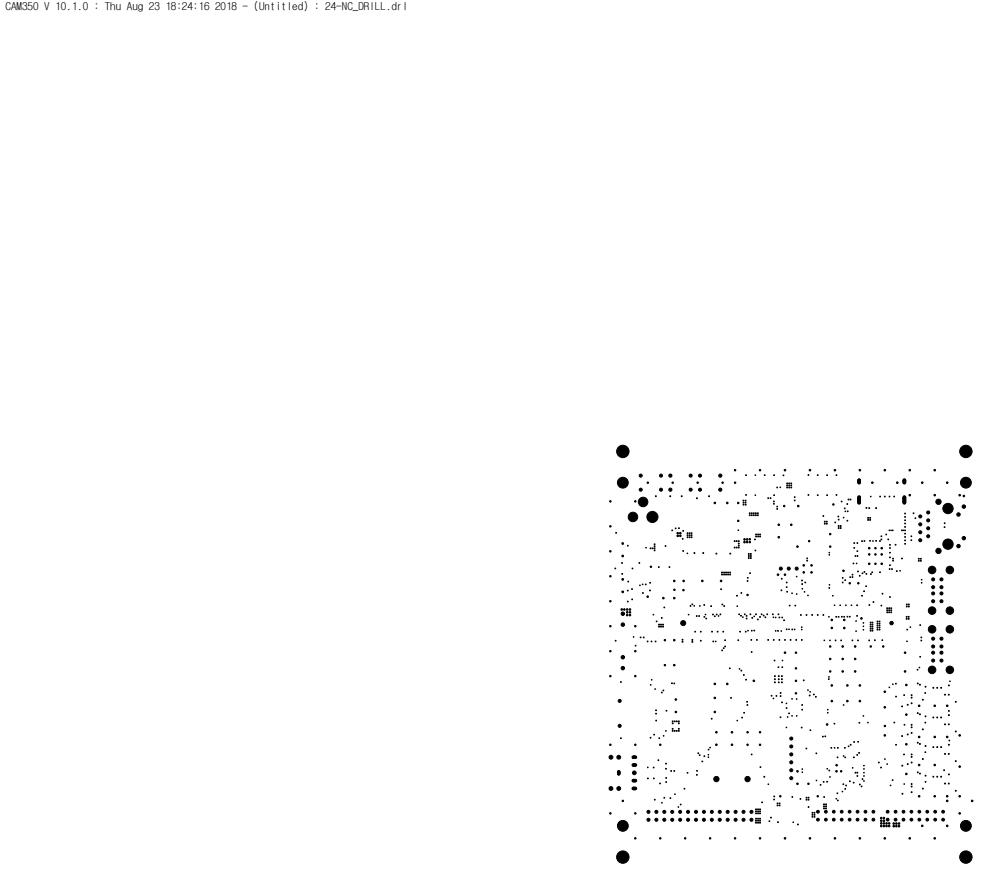
[picture p40: page 12]

CAM350 V 10.1.0 : Thu Aug 23 18:24:16 2018 - (Untitled) : 24-NC_DRILL.drl
