leesanghun-droid/A-project/smt견적용 데이터/mask_data.pdf

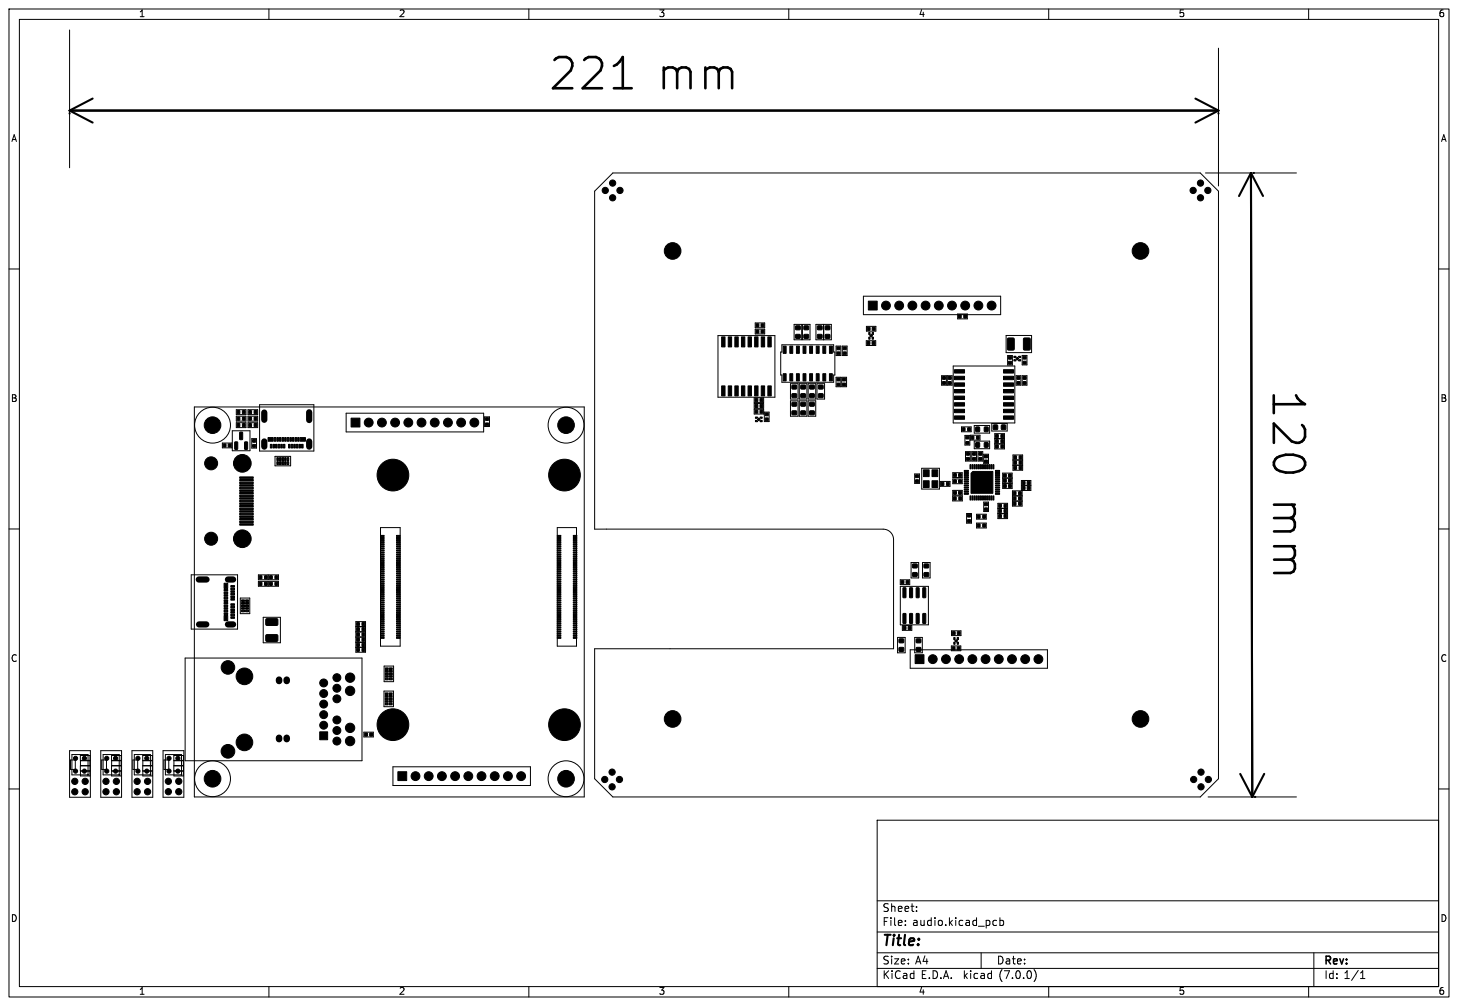
[picture p41: page 1]
