leesanghun-droid/A-project/(list of files, drawings)

Other design files:
참고자료/FN200-RPI-CM_REV_A1(180823)PCB-2D.pcb
참고자료/FN200-RPI-CM_REV_A(180608)PCB-1F.pcb
참고자료/FN200-RPI-CM_SOUNDIT_REV_A1(180822)SCH_2AB.DSN
참고자료/FN200-RPI-CM_SOUNDIT_REV_A(180608)SCH-1CA.DSN
참고자료/FN210-RPI-W/FN210-RPI-W/FN210-RPI-W_SOUNDIT_REV_A(190304)SCH-1AA.DSN
참고자료/FN210-RPI-W/FN210-RPI-W/FN210-RPI-W_SOUNDIT_REV_A(190304)SCH-1AA.opj
