leesanghun-droid/A-project/(commit log)

2022-11-28 .
    .
    [BOM_2022.11.28.xlsx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]
2022-12-10 high_speed_artwork_done
    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
    [CM4_LOW_SPEED.kicad_sch, audio.kicad_pcb]
2023-02-14 ,
    ,
    [4ch_mic.kicad_sch, CM4_LOW_SPEED.kicad_sch, audio_BOM_2023.02.14.22.00.xlsx]
2023-02-25 USB_OK
    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
    [4ch_mic.kicad_sch, CM4_LOW_SPEED.kicad_sch, CM4_docker.kicad_sch, POWER_sch.kicad_sch]
